lukasznowarkiewicz/I2C-SMBus-on-x86-architecture-research/README.md

# I2C / SMBus on x86 architecture research  
  
## Motivation  
  
I2C bus is super simple - most basic bus and foundation for digital communication, like DDC in HDMI, SPD in computer memory modules,  SMBUS in “Smart battery”, PMBUS for power management, image sensors configuration in CSI cameras, and so on and on.   
  
Talking to those devices on a MCU in C language is simple - often limited to communication with peripheral for sending and receiving data. But it gets more complicated on x86 architecture, which can be found in many computer systems (aka personal computers and laptops). Simple Cortex M0 core running at 100MHz is “just” one thousand faster than the slowest 100kbps I2C bus speed. But on average modern CPU running at 3GHz it is 30 thousand times faster. There is no surprise that CPU is not talking to I2C peripherals directly as probably it is waste of interrupts - as changing context on CPUs this complex is really wasteful for pipeline processing.   
  
As already found that many of small sensors like temperature, fan controllers, additional buttons aka “hot heys”, orientation sensors or even touchpads works on I2C or some variation of it like SMBUS. And was just curious how to communicate with them from the operating system. And of course all those reflections are related to future x86 project.   
  
## Approach  
  
Build simple prototype board with a few sensors working on I2C / SMBUS bus connect it to a x86 motherboard with exposed I2C signals and try to access them from the operating system.   
  
## Goals:  
  
Goals for this quick research are low - start small and achieve some basic functionality:  
  
- Communicate with some sensors on linux using i2c tools  
- Bind already build driver to a device on linux  
- Communicate with sensors on Windows 11  
  
## Understanding I2c handling on x86 architecture   
  
On an x86 SoC, I2C transfers are generated by dedicated I2C controller hardware, similar in principle to MCU I2C peripherals, but the controller is integrated into a much larger platform with firmware, pin muxing, power management, and OS enumeration around it. First, firmware configures the pads so the selected pins work as SDA/SCL instead of GPIO or another alternate function, then it enables or describes the I2C controller and any fixed devices connected to that bus. When software requests a transaction, the CPU does not bit-bang the bus; it programs controller registers or uses DMA/FIFO mechanisms, and the controller generates START, address, ACK/NACK, data bytes, repeated START, STOP, and clock timing. The important difference from a small MCU is not the existence of an I2C peripheral, but the amount of platform infrastructure around it: ACPI/firmware tables, controller drivers, device drivers, interrupts, runtime power states, and security/ownership rules. Later in the OS stack, the I2C controller becomes a bus adapter, devices on that bus become child devices, and normal applications usually access the sensor through a driver-specific or framework-specific interface rather than by directly controlling bus transactions.   

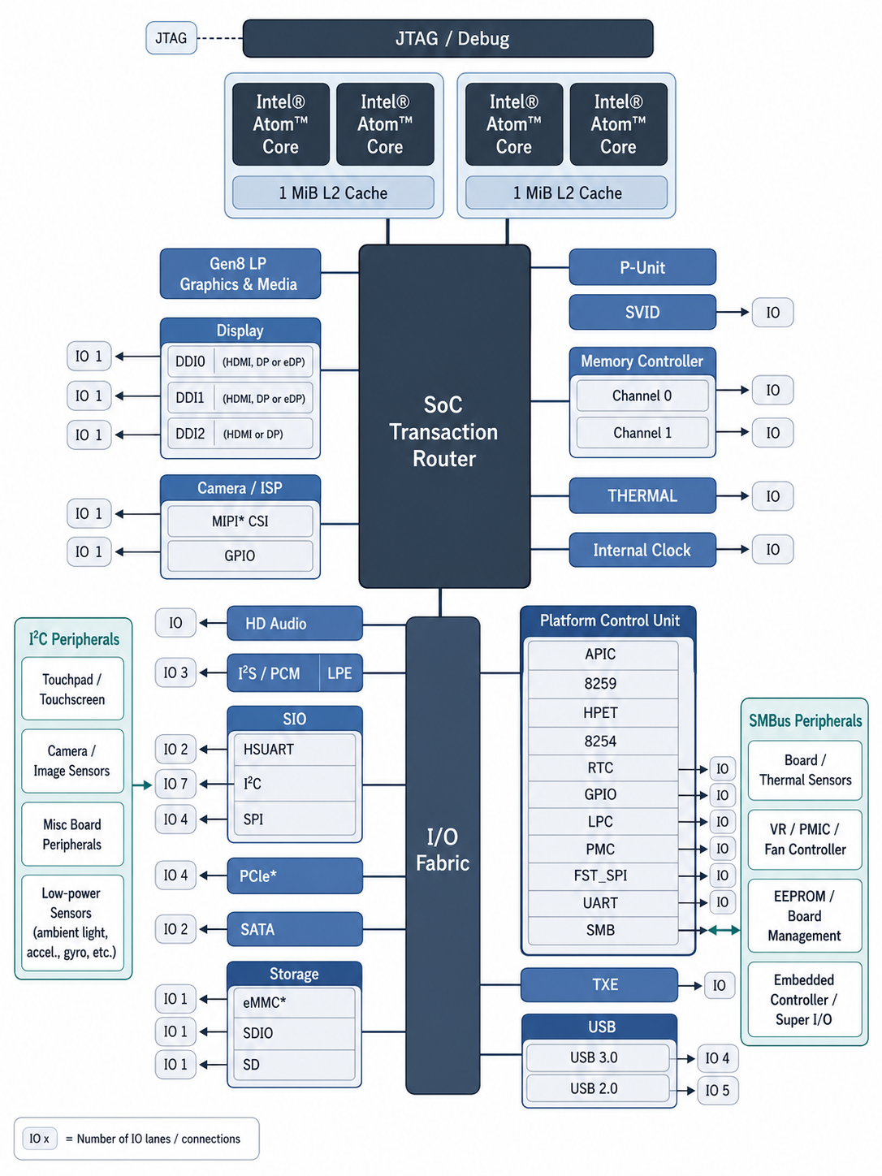
[picture p1: Attachments/B711AB3C-D2A0-412D-849C-1D97AC93C686.png]
01 •
  

## Components selection for the research  
  
For the component selection, I tried to find parts that are commonly mounted on x86-based motherboards and have proven Windows support. For the temperature sensors, I found that TMP101 and TMP175 are widely used as internal temperature sensors. For fan-speed readings, I selected the MAX6650EUB+. For the IMU/gyroscope, I chose the Bosch BNO055, the MPU-6050, and the ST LSM6DSOTR. For the GPIO expander, the choice was more arbitrary, as I could not find clear listings of specific chips used in laptops. Usually, this functionality is hidden behind a driver package for a particular laptop model, often described only as “hot keys support”.

## Hardware design - schematic  
  
In the schematic, almost all devices are connected to a single I²C bus. The board uses 5 V as the main supply, mainly because of the 5 V fan, and an LDO regulator generates the 3.3 V rail for the remaining circuitry. Pull-up resistors are provided for the SDA and SCL lines, as well as for the overtemperature signal, which could be used, for example, as a `PROC_HOT` signal.

### Schematic:  
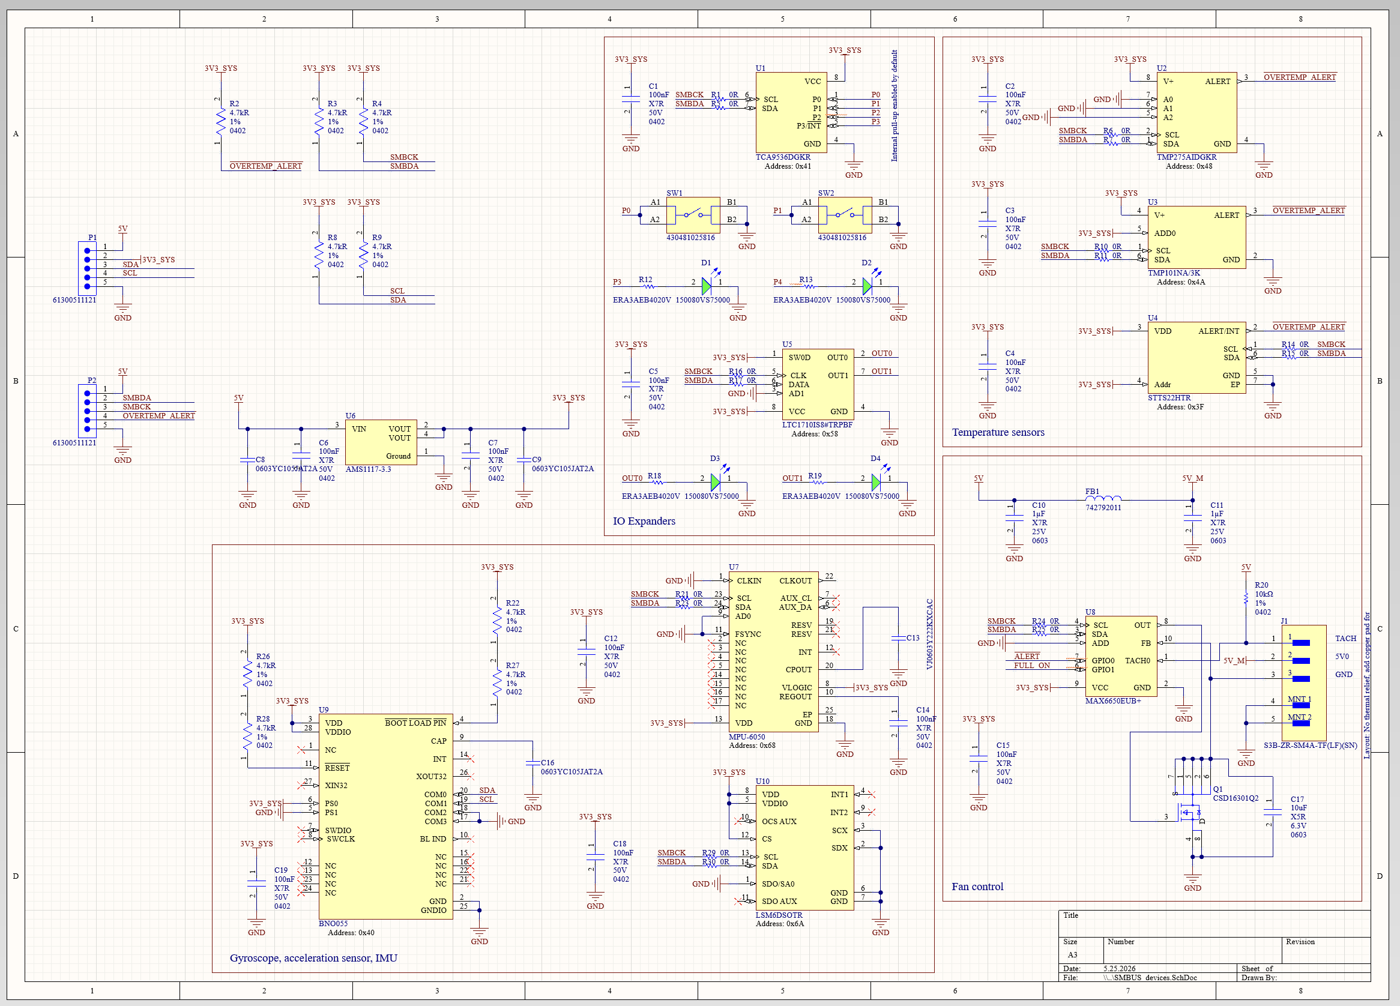
[picture p2: Attachments/11CCCEA3-3A21-467D-BA31-D675517985C5.png]
Screenshot 2026-05-25 at 19.46.35.png
  

## Hardware design - board  
  
Since I had little free time while designing the board, I decided to try PCBWay’s layout service.

I shared the entire Altium project, with the components already imported into the PCB layout:

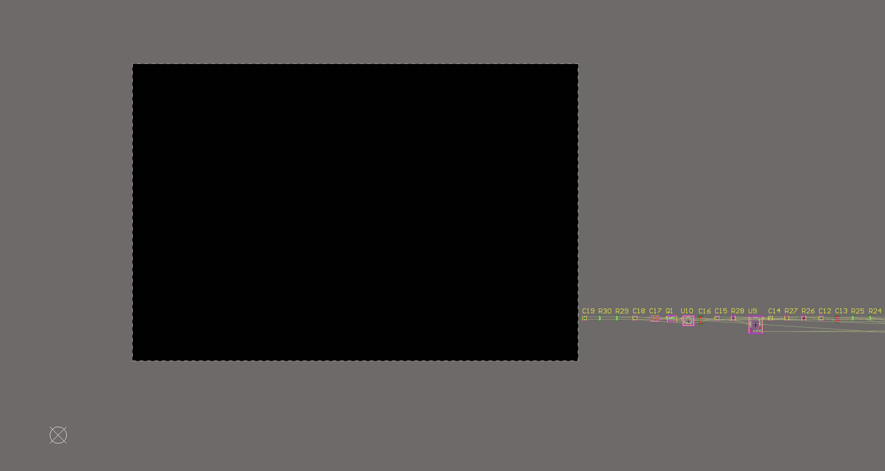
[picture p3: Attachments/1C58EC97-9770-488D-8159-F59337C1017C.png]
Screenshot 2026-06-06 at 08.18.42.png
  
  
I submitted the layout order through the PCBWay website:
  
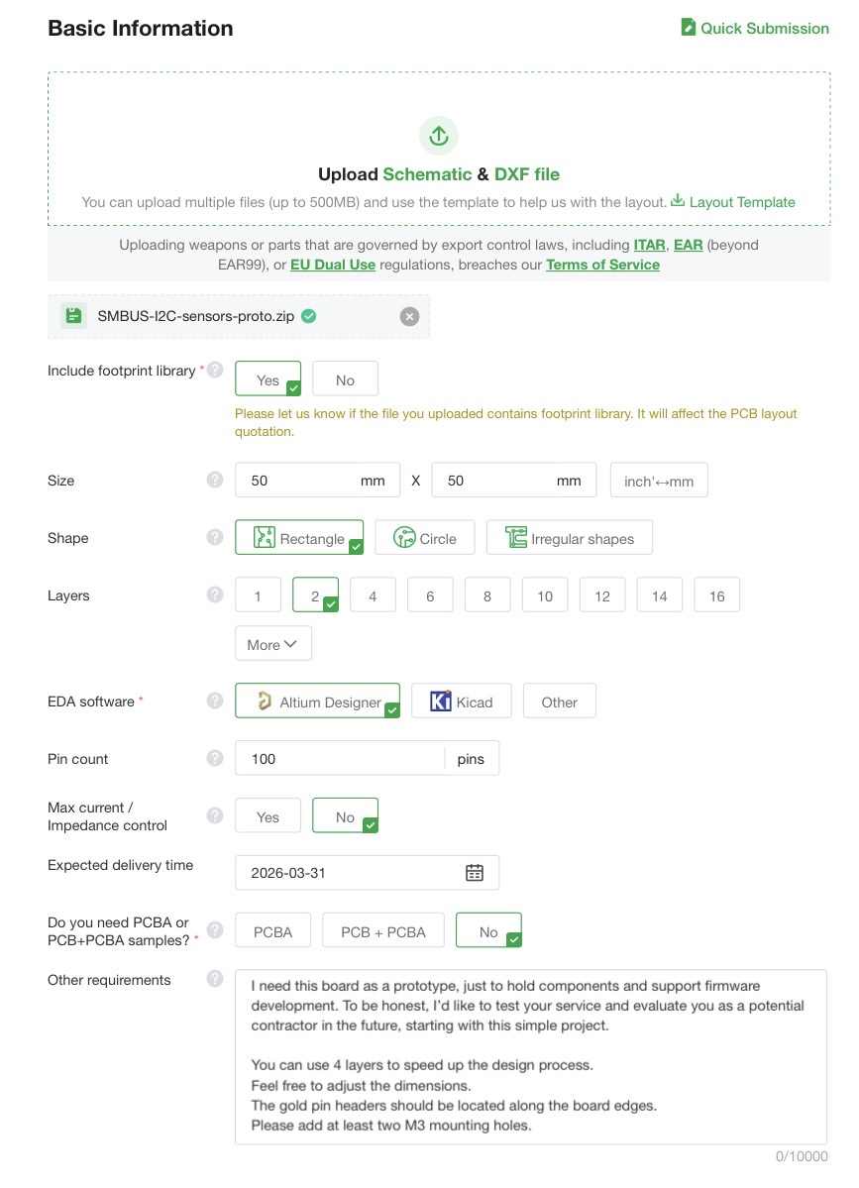
[picture p4: Attachments/9A4FDA5C-38B8-45B0-8BFF-E47C227ACC96.jpeg]
Basic Information
  
  
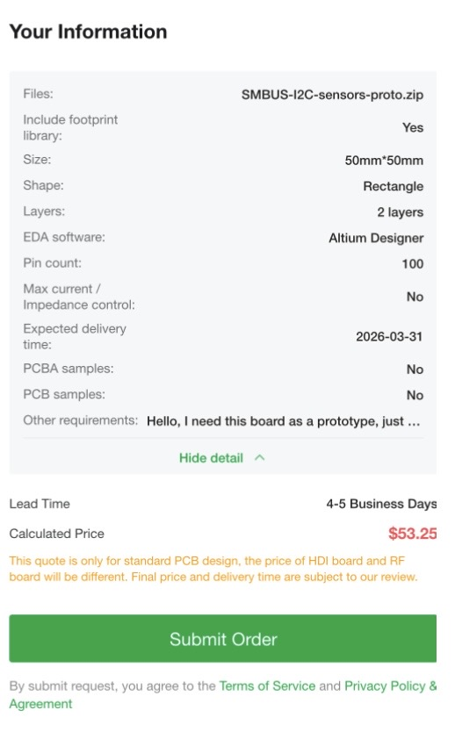
[picture p5: Attachments/A5CA129C-3088-495A-BF5F-B8A964FA2149.jpeg]
Your Information
  
  
I then received the initial component placement for review:
  
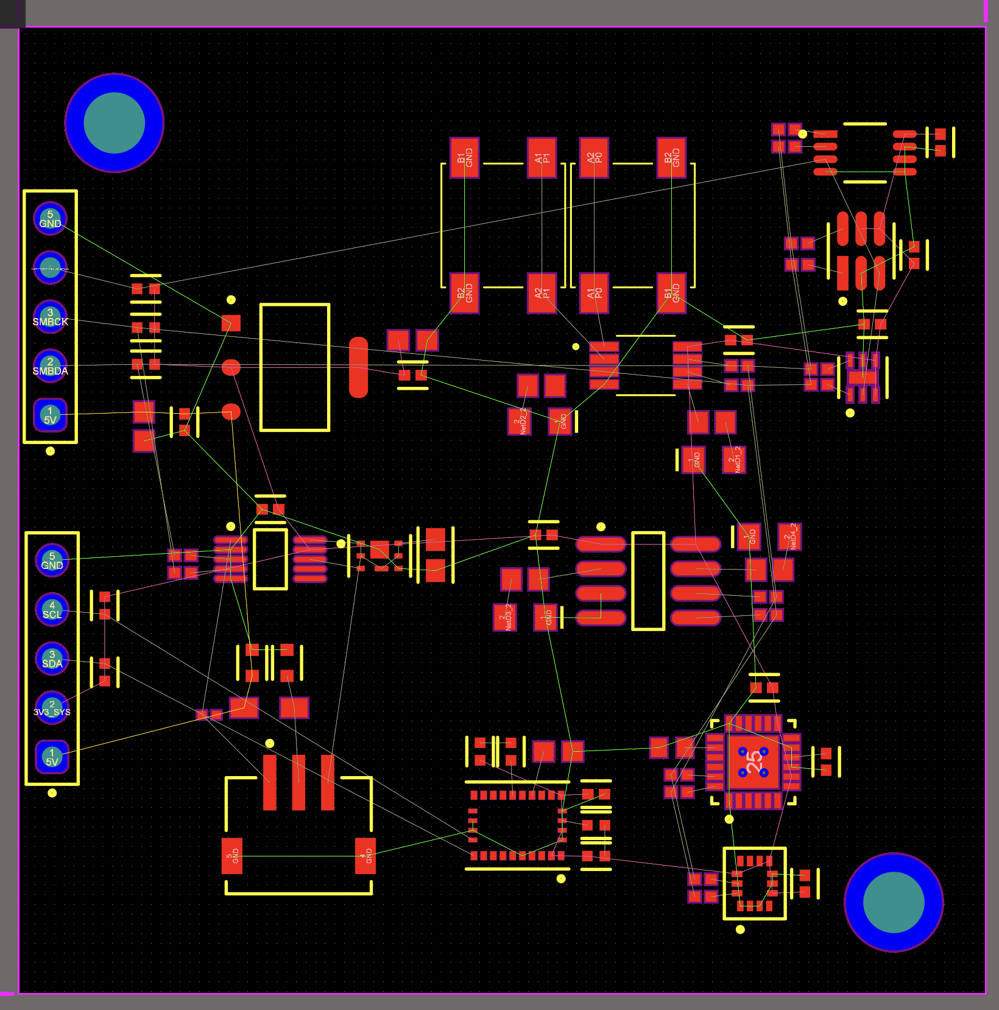
[picture p6: Attachments/7B85AB8D-54B4-4485-B792-E42F1DB74CB3.png]
KI
  
  
My feedback on the placement was to increase the distance between the switches, move the connector to the edge of the board, and add two additional mounting holes:
  
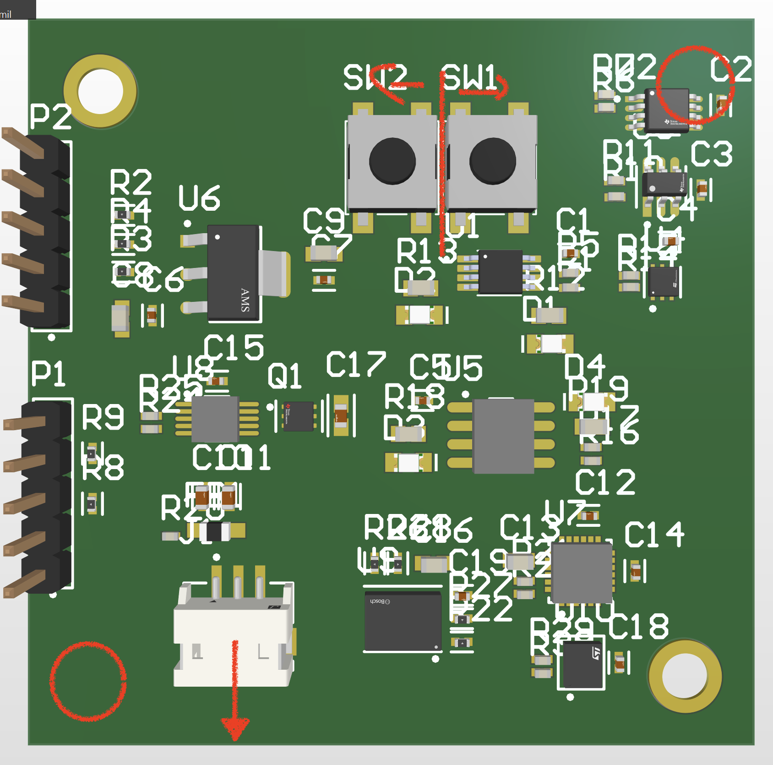
[picture p7: Attachments/5A142E30-4AD3-4D96-9F7F-76EDBB8770F3.png]
U6
  
  
I then received the final design:
  
Board:  
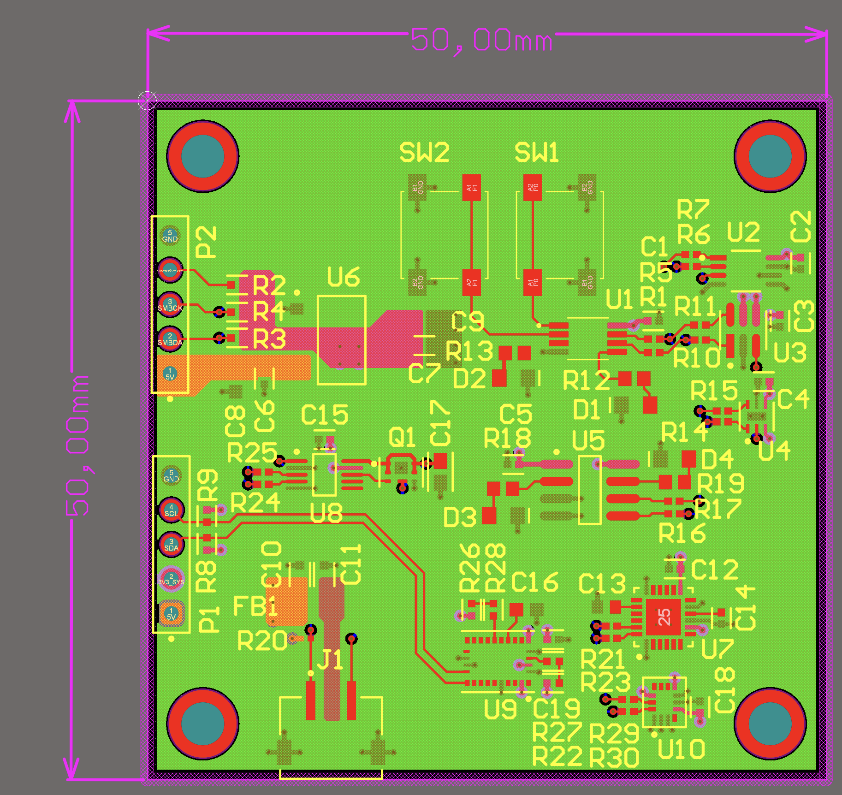
[picture p8: Attachments/AACE3CC7-D583-425D-85B8-28C8F25D9579.png]
•C8
  
  
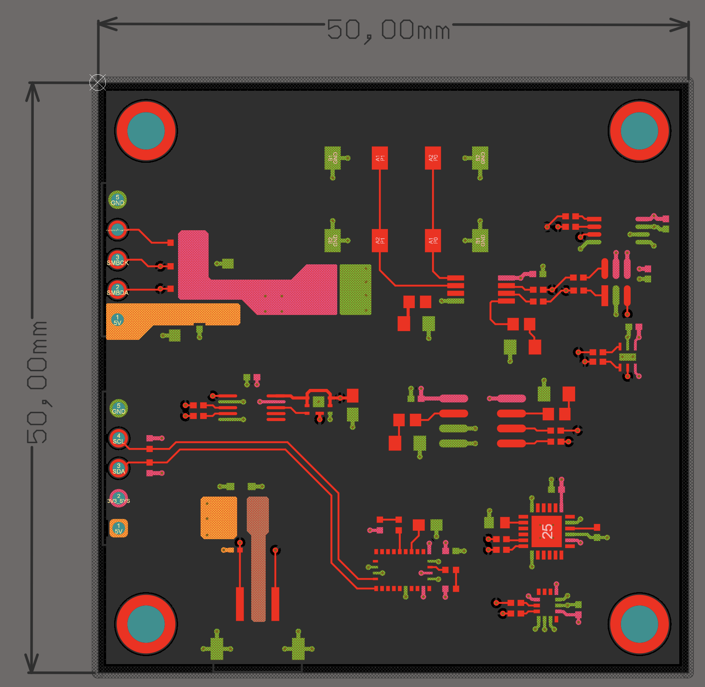
[picture p9: Attachments/97C273D0-FF5C-45F0-910F-7EBCFD2107C6.png]
50,00mm*
  
  
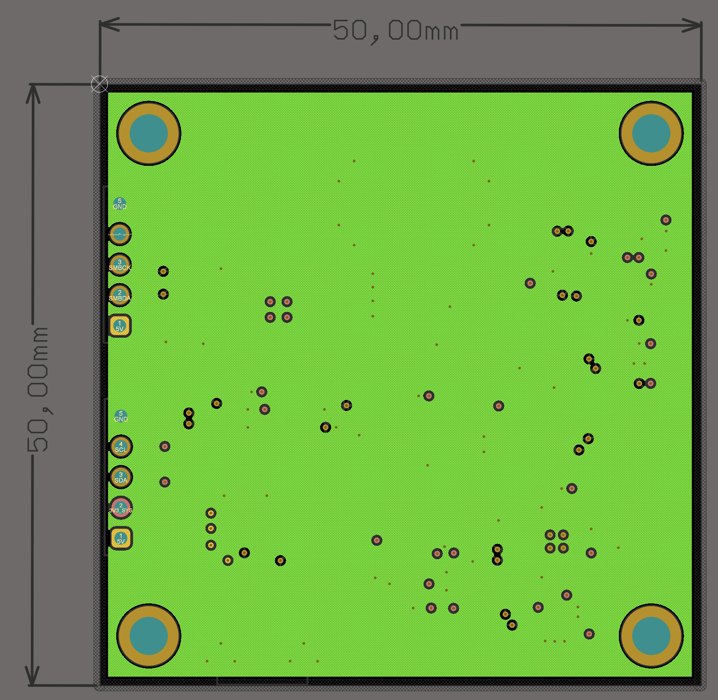
[picture p10: Attachments/A66A80FC-ED96-4A03-A9B6-D786C6430050.png]
50,00mm
  
  
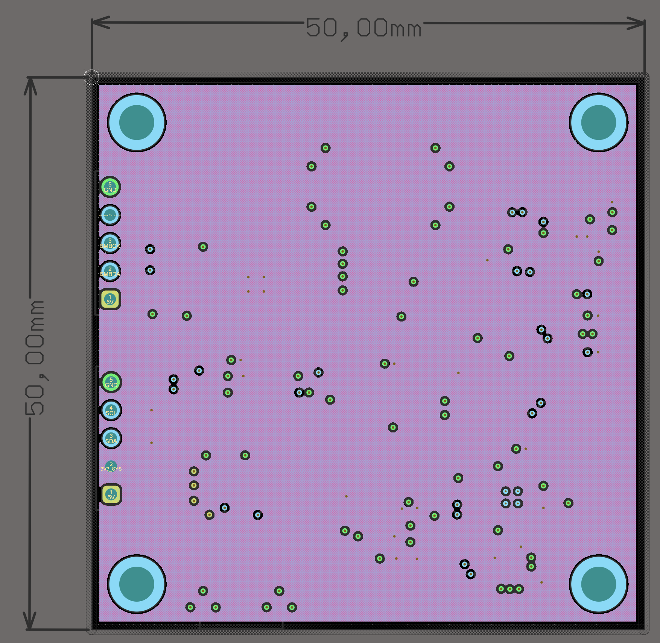
[picture p11: Attachments/0505F2DE-9F41-4C99-9035-F0E51C881270.png]
50, 00mm
  
  
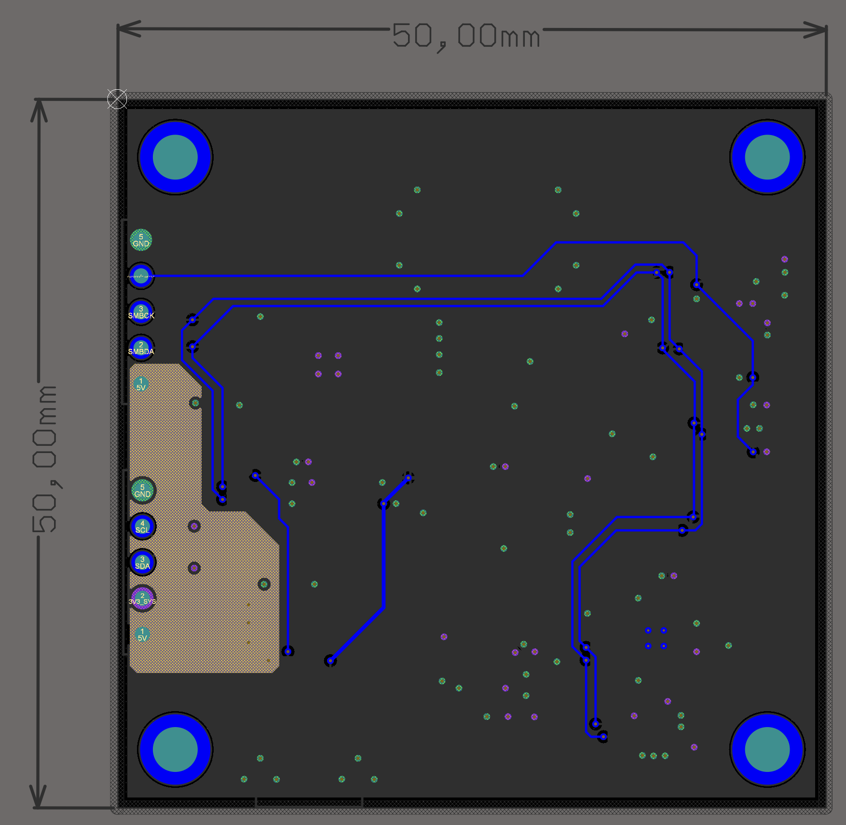
[picture p12: Attachments/32863FE4-E380-45B1-AFA6-61666BC4C738.png]
50, 00mm"
  
  
3D view:  
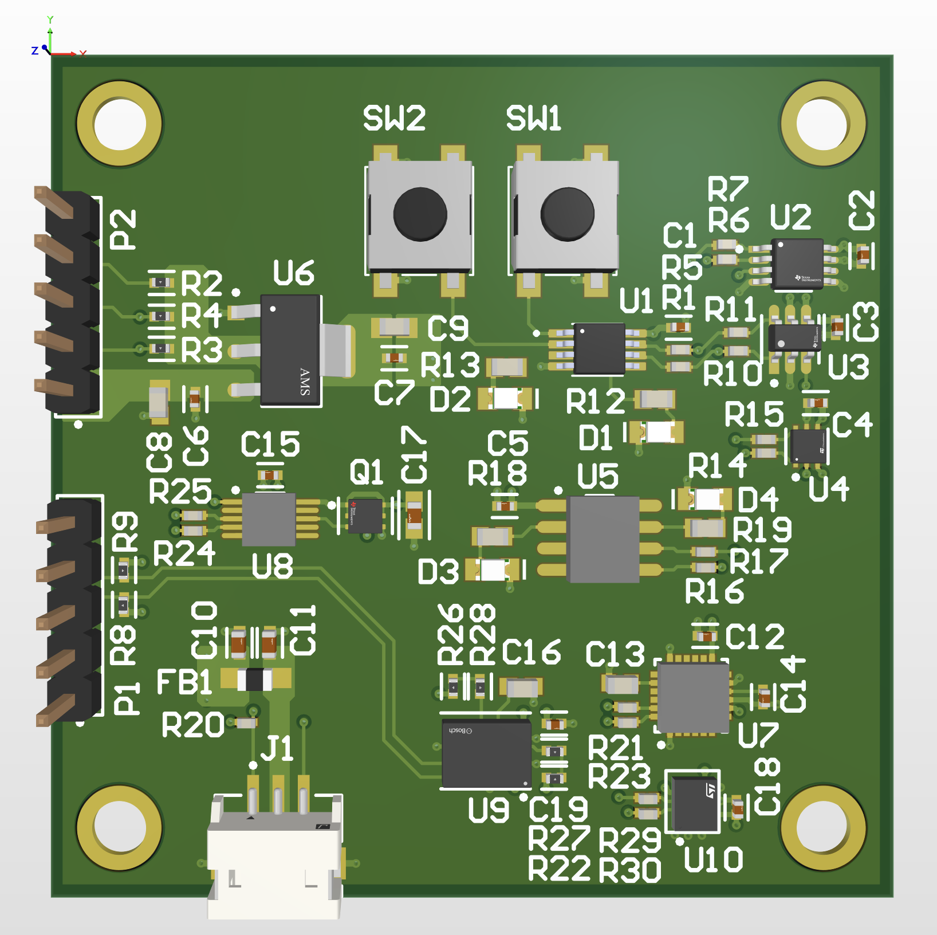
[picture p13: Attachments/F3828EFC-0B8C-4B9E-B2CE-DBCD29BB3CEA.png]
ER2.
  

**Layout review:** 
  
Overall, I am quite satisfied with the result. There was one mistake in the schematic, which was pointed out by a PCBWay engineer after the PCB layout was ordered. The routing was done properly: the I²C lines were routed together, the power traces and planes were made wider, and the internal planes were connected with multiple vias. There were also no acid traps in the tracks, so overall the layout quality was quite good. From my perspective, I would only add additional copper planes for mechanical rigidity around the buttons, fan connector, and gold-pin headers.
  
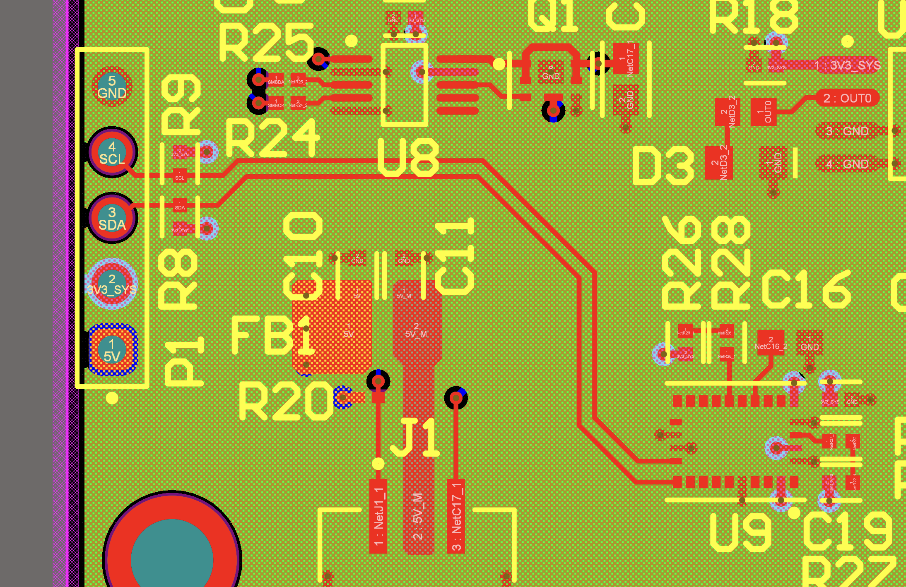
[picture p14: Attachments/629187CA-9BAF-429B-819C-90AB1296BFAC.png]
R250-
  
  
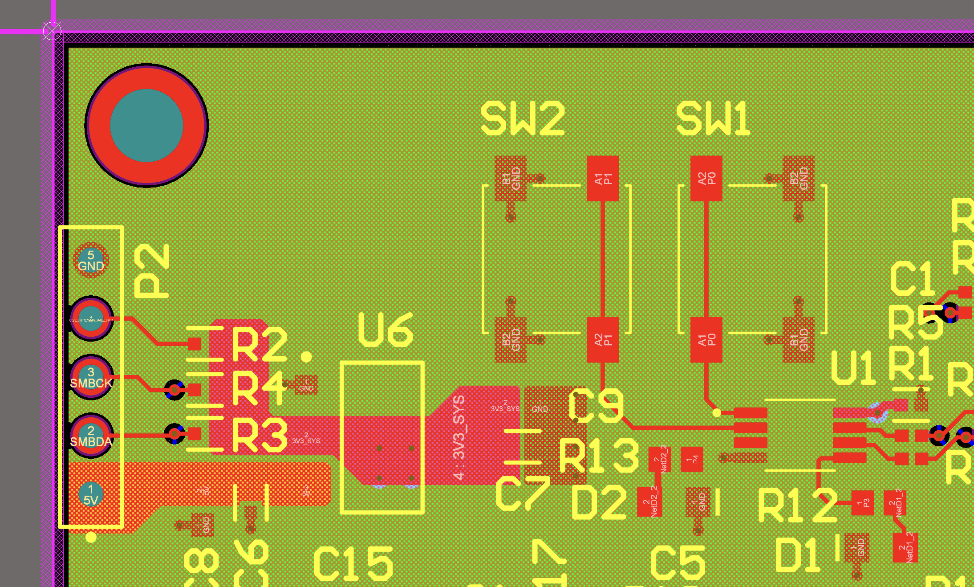
[picture p15: Attachments/8C8C0536-181C-49AF-8A91-1FA4AB64D4E4.png]
Screenshot 2026-05-25 at 19.53.40.png
  
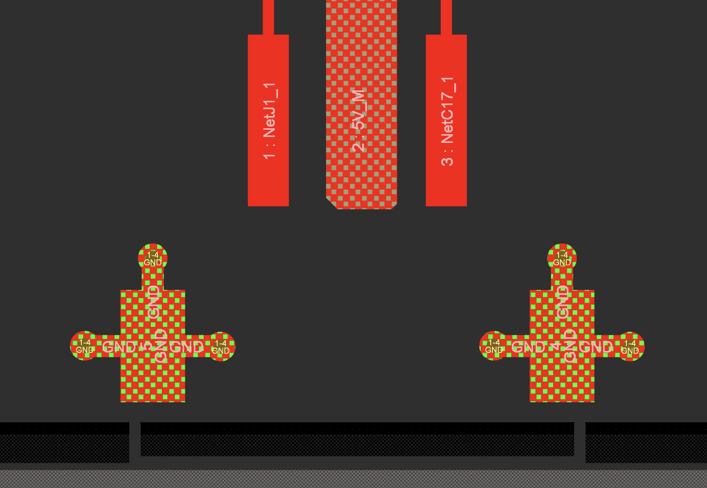
[picture p16: Attachments/A37CA132-9B90-4D5D-A9C6-D6964F79153A.png]
1: Net.1 1
##   
  
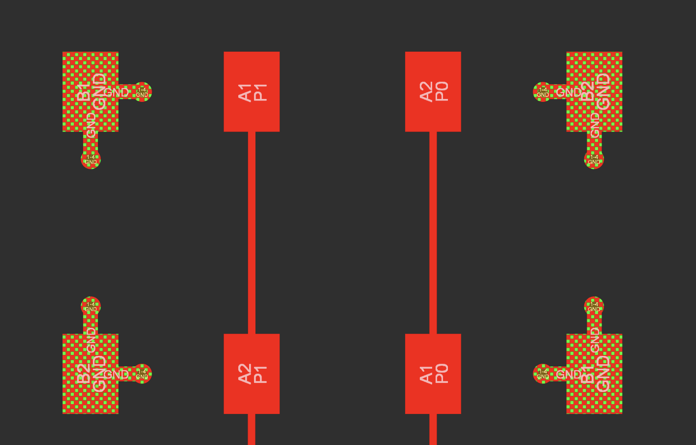
[picture p17: Attachments/AAB1B498-46C1-4410-B1E2-F75117983525.png]
Screenshot 2026-03-11 at 07.10.37.png
  
  
## Hardware manufacturing - PCB and assembly  
  
The PCBs were ordered with PCBWay’s assembly service. This part was partially sponsored by PCBWay, for which I am very grateful. It saved me a lot of time, and surprisingly, even with the assembly service, it turned out to be cheaper than buying the parts separately and hand-assembling the boards myself in Europe.

Why? Logistics.

A few ICs I selected turned out to be difficult to source in Europe. I usually use OEMSecrets for component sourcing, but several crucial components were unavailable from major distributors such as Mouser, DigiKey, and Farnell. I found them on Alibaba and AliExpress, but for such small quantities, most of the cost would have been shipping and logistics.

Surprisingly, sourcing the components was not a problem on the Chinese domestic market. After submitting the BOM, only two components required my attention. The first issue was just an MPN difference caused by different packaging. The second was a different variant of the same component: only the extended-temperature-range version was available.

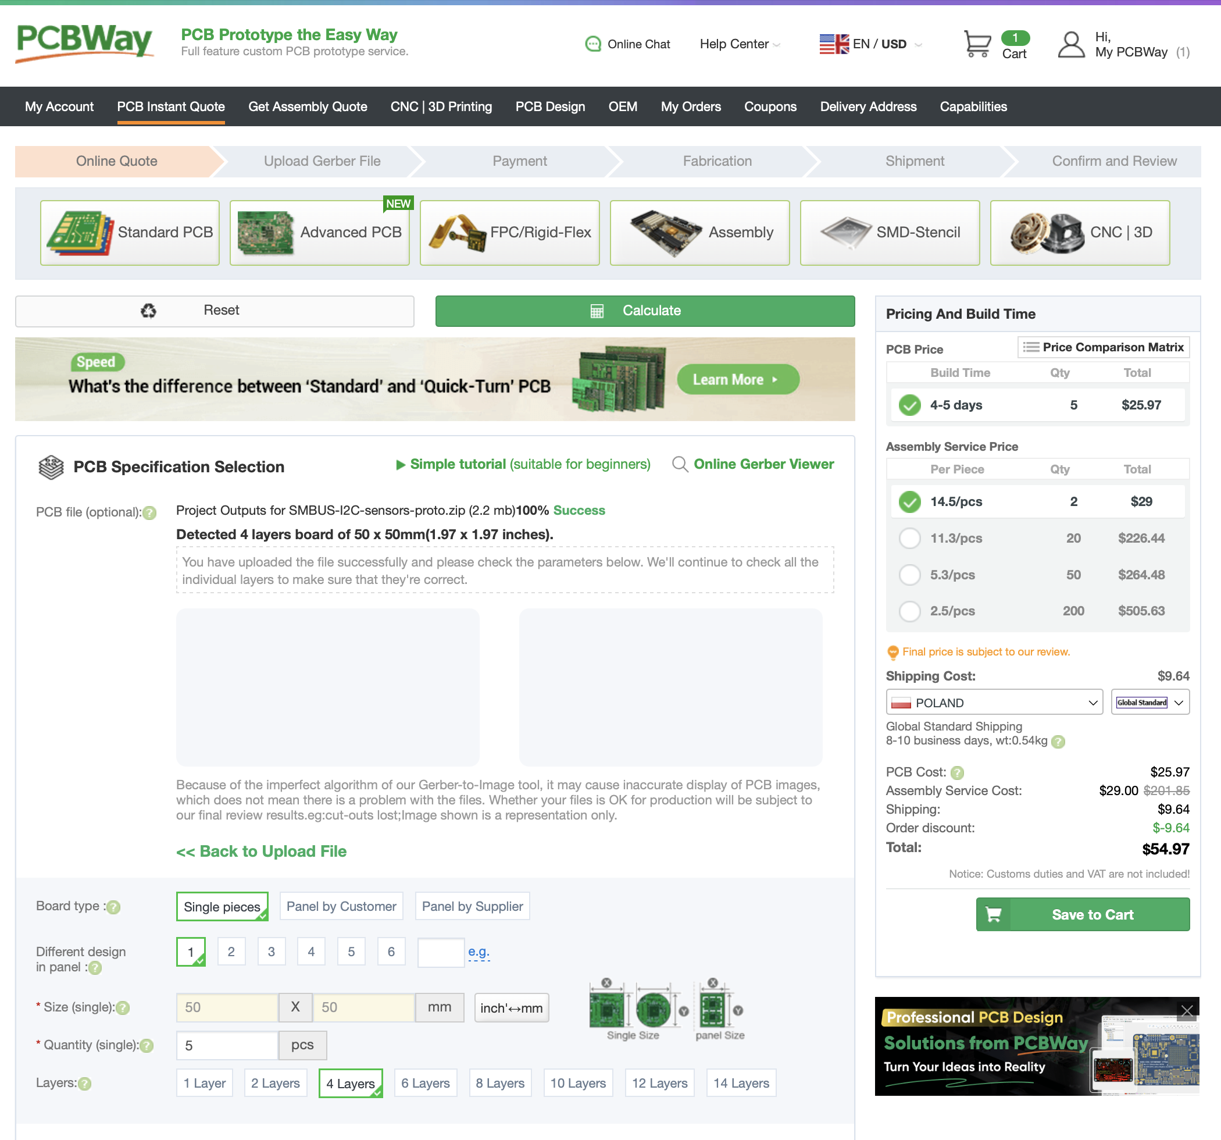
[picture p18: Attachments/C0818001-4557-412D-B9E1-4B0FE3AE6DCB.png]
PCBWay *ce Proctype the Easy Way
  
  
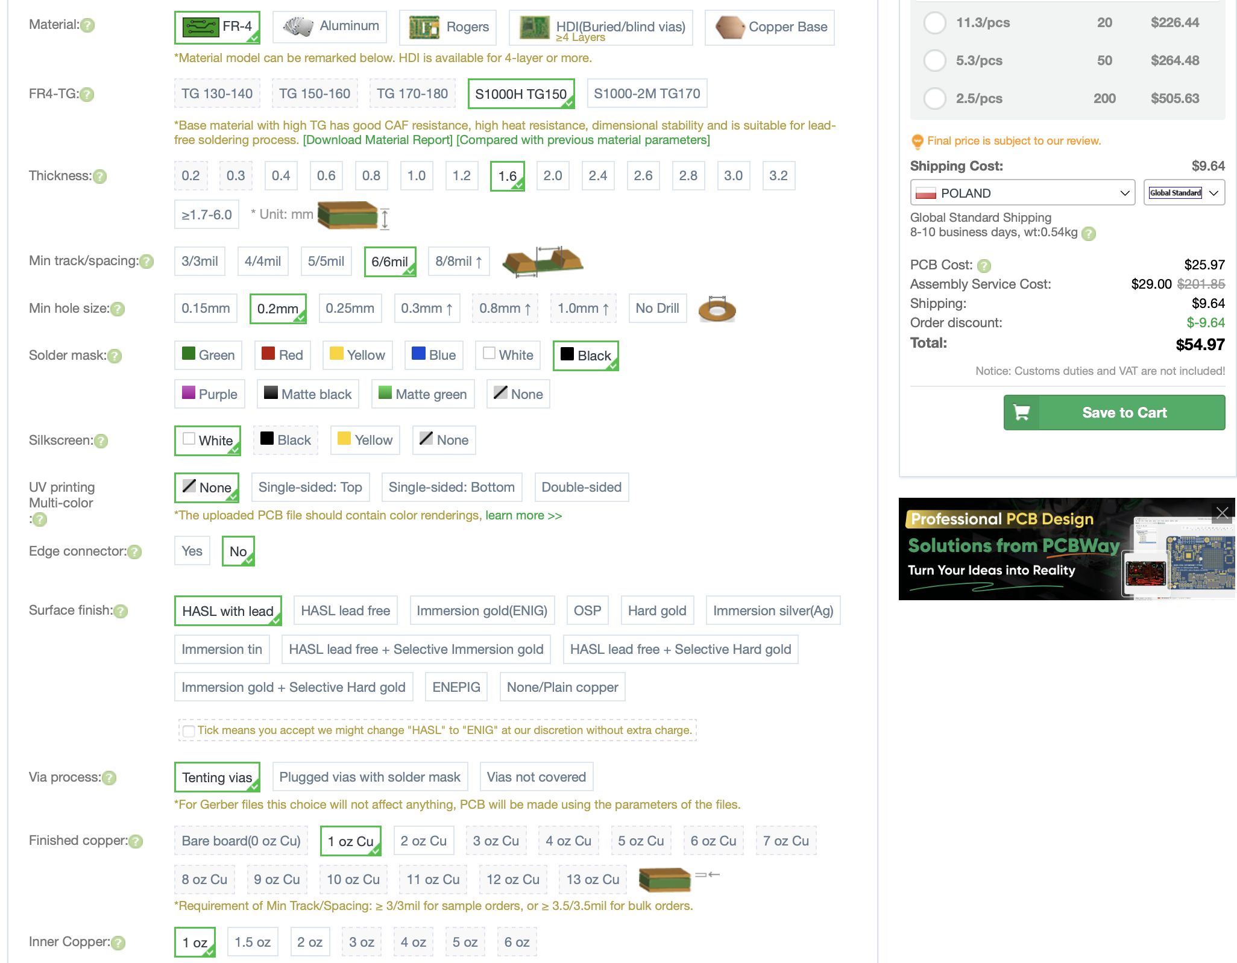
[picture p19: Attachments/0A75F936-AF28-4116-A1AB-D14D3182B3FE.png]
TO 130-540 10 150-10015:00-180|
  
  
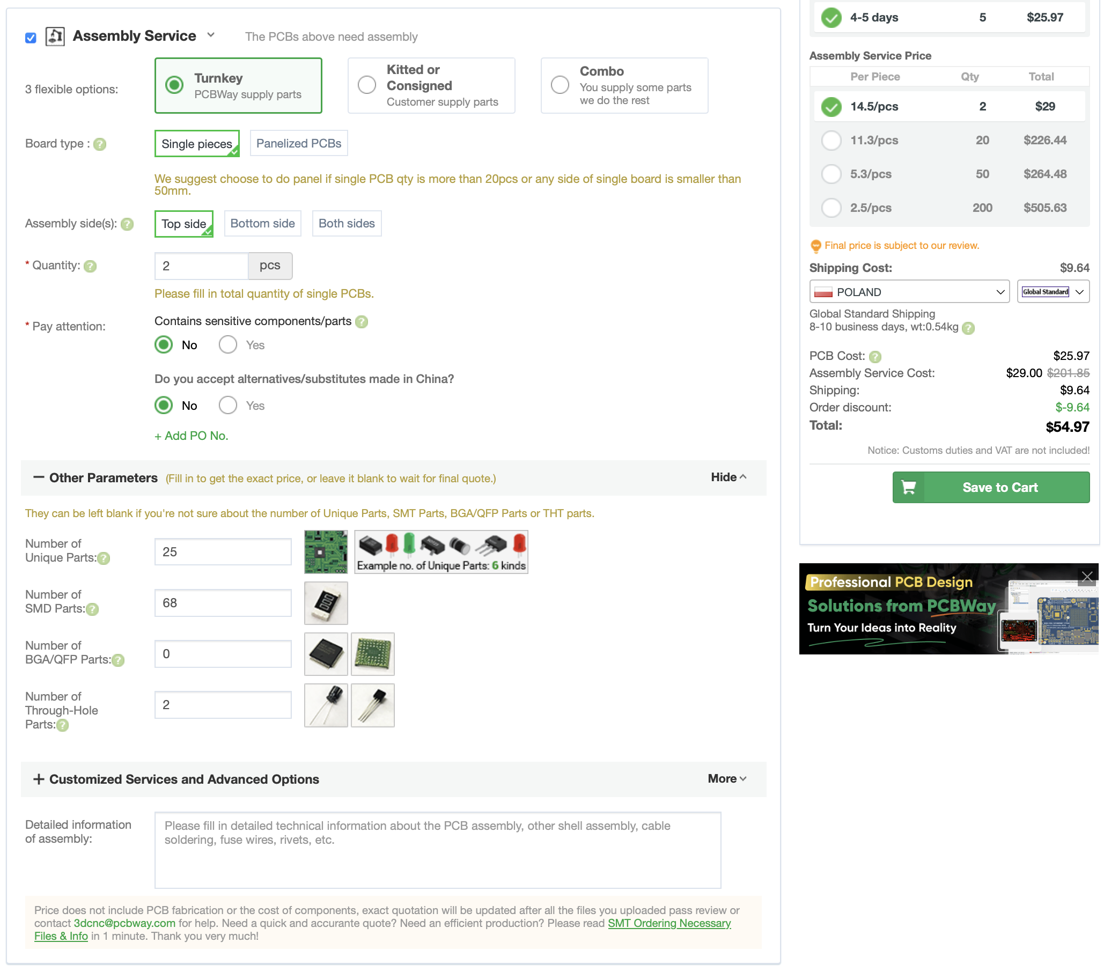
[picture p20: Attachments/6A373418-B24C-4D91-A0F8-FB6A06A81E18.png]
• hi Assembly Service i
  
  
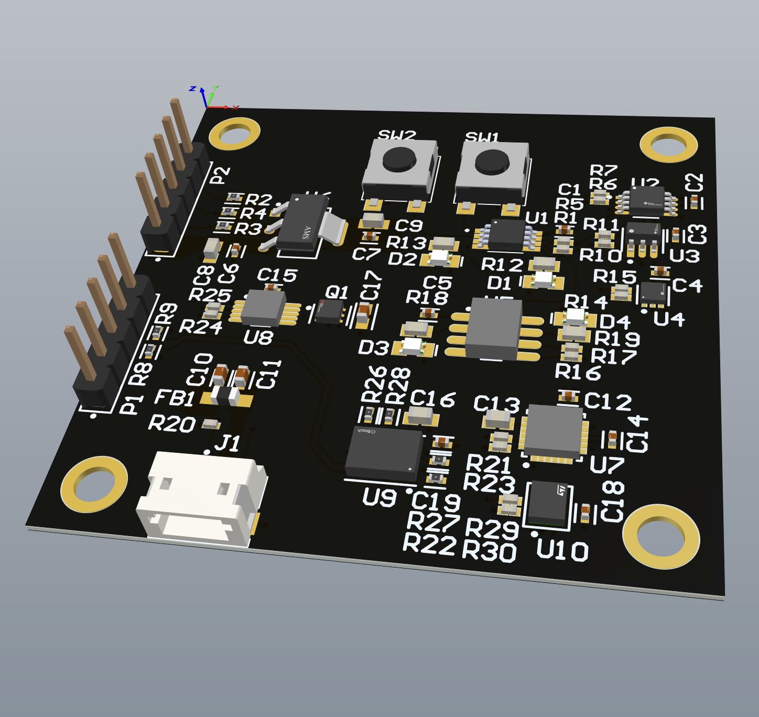
[picture p21: Attachments/D233D81A-FD06-44EF-BE42-712F0A1E425E.png]
R25
  

The received boards look great, including both the SMD-mounted components and the hand-soldered THT components.

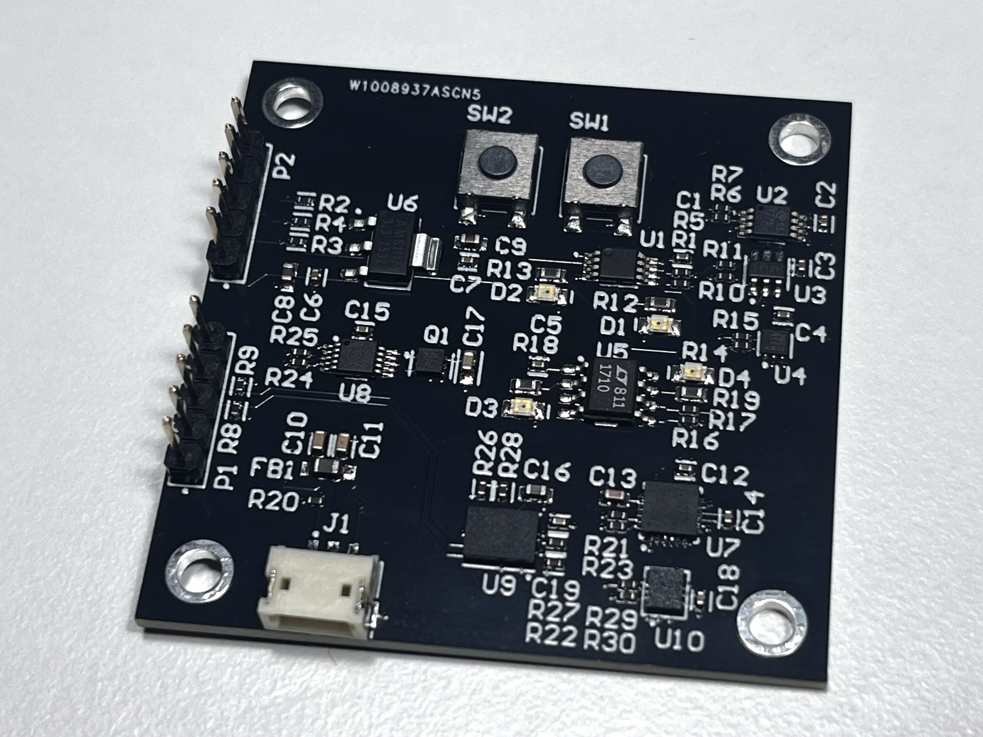
[picture p22: Attachments/01940D4C-41E8-4D1B-A3C4-8568F3423B43.jpeg]
  
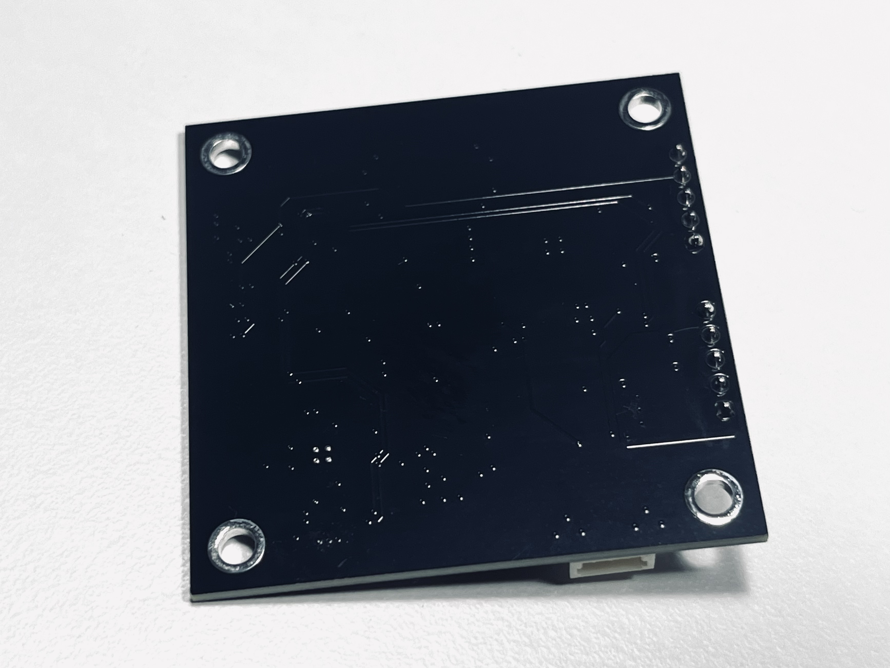
[picture p23: Attachments/EC33EA2C-758D-49B1-975E-90392AE3E7BD.jpeg]
  

## Hardware test setup  
  
It is not easy to find exposed I²C lines on most modern motherboards. One board where I could find them was the LattePanda Mu with the Lite Carrier Board, so I used it for the test setup.

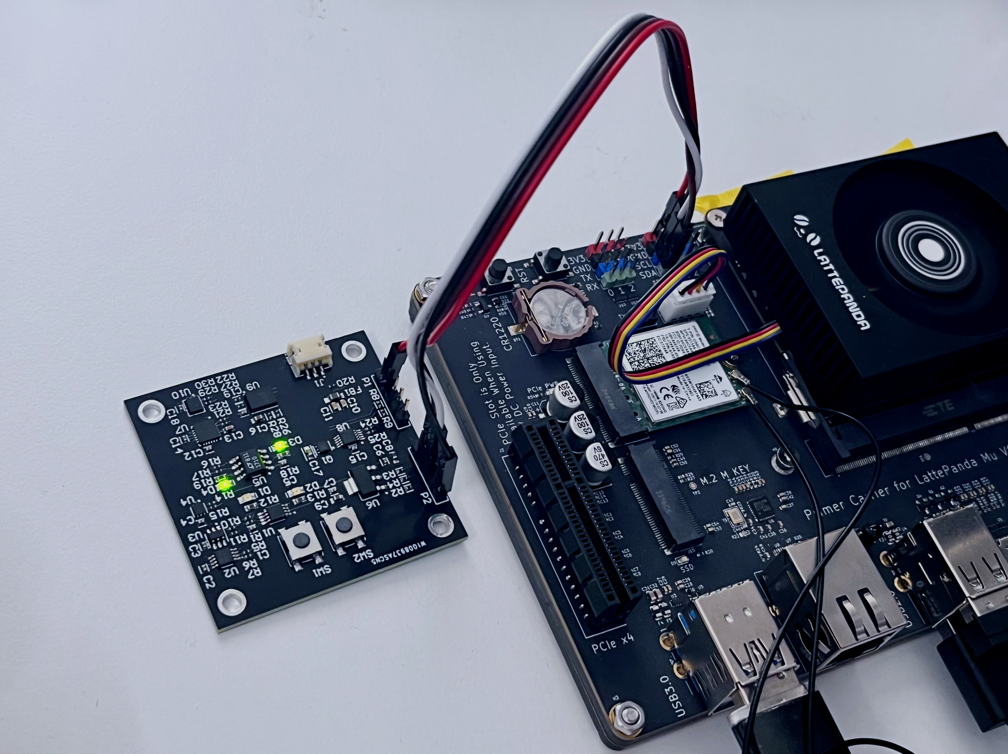
[picture p24: Attachments/2FA29C56-B4CF-44B3-9106-82A8949B6986.png]
Screenshot 2026-06-14 at 08.41.12.png
  
  
## Software test setup - Linux  

Picked most layman friendly Linux - Lubuntu 26.04  
It is equipped with apt for easy software install, comes with thousands of drivers, easy for install - seems to be good choice for a quick start.  
It runs of a usb drive as a live ISO.  
When installing or running from usb drive I believe no one ponder “from where did it know all the hardware on the motherboard?”. It just works and no one cares. But actually it is quite interesting. On most ARM platforms Linux kernel expects so called device tree binary (.dtb file) - describing all peripherals and their addresses in the memory. On x86 this information is stored in the firmware (BIOS/UEFI) in a form so called ACPI tables. This approach makes OS installation much easier as the firmware already contains information about the hardware and supplying device tree externally is not required. Linux reads it and loads required drivers. For already described modules like touch screen controller or internal temperature sensors they will “automagically” start to work. For external devices, such as a custom board with I²C sensors, Linux provides a convenient way to experiment without modifying low-level firmware, which could easily make the device harder to recover. The `i2c-tools` package uses the Linux I²C userspace interface exposed through `/dev/i2c-*`, typically provided by the `i2c-dev` kernel module. This makes direct bus testing much easier during bring-up.

## 1st goal - communication with devices on Linux using I2c-tools   
  
For the first part i2c-tools package will be used for direct communication with the devices. Intel N100 processor has 7 I2C master controllers - finding the right one was try and error method - looking for devices at expected addresses.   
  
List all available buses on the system:
```bash  
lubuntu@lubuntu:~$ i2cdetect -l  
i2c-0	unknown   	Synopsys DesignWare I2C adapter 	N/A  
i2c-1	unknown   	Synopsys DesignWare I2C adapter 	N/A  
i2c-2	unknown   	Synopsys DesignWare I2C adapter 	N/A  
i2c-3	unknown   	Synopsys DesignWare I2C adapter 	N/A  
i2c-4	unknown   	Synopsys DesignWare I2C adapter 	N/A  
i2c-5	unknown   	SMBus I801 adapter at 0000:00:1f.4	N/A  
i2c-6	unknown   	i915 gmbus dpa                  	N/A  
i2c-7	unknown   	i915 gmbus dpb                  	N/A  
i2c-8	unknown   	i915 gmbus dpc                  	N/A  
i2c-9	unknown   	i915 gmbus tc1                  	N/A  
i2c-10	unknown   	i915 gmbus tc2                  	N/A  
i2c-11	unknown   	i915 gmbus tc3                  	N/A  
i2c-12	unknown   	i915 gmbus tc4                  	N/A  
i2c-13	unknown   	i915 gmbus tc5                  	N/A  
i2c-14	unknown   	i915 gmbus tc6                  	N/A  
i2c-15	unknown   	AUX USBC2/DDI TC2/PHY TC2       	N/A  
```  

Found devices on bus 4:  
```bash
lubuntu@lubuntu:~$ sudo i2cdetect -r -y 4                    
     0  1  2  3  4  5  6  7  8  9  a  b  c  d  e  f  
00:                         -- -- -- -- -- -- -- --
10: -- -- -- -- -- -- -- -- -- -- -- -- -- -- -- --
20: -- -- -- -- -- -- -- -- -- -- -- -- -- -- -- --
30: -- -- -- -- -- -- -- -- 38 -- -- -- -- -- -- --
40: -- 41 -- -- -- -- -- -- 48 -- 4a -- -- -- -- --
50: -- -- -- -- -- -- -- -- -- -- -- -- -- -- -- --
60: -- -- -- -- -- -- -- -- 68 -- 6a -- -- -- -- --
70: -- -- -- -- -- -- -- -- 
```

Detected devices:  
  
`0x38` - STTS22HTR  
       ST digital temperature sensor.  
  
`0x41` - TCA9536DGKR  
       TI 4-bit I2C GPIO / I/O expander.  
  
`0x48` - TMP275AIDGKR  
       TI digital temperature sensor with alert output.  
  
`0x4A` - TMP101NA/3K  
       TI digital temperature sensor with alert output.  
  
`0x68` - MPU-6050  
       TDK/InvenSense 6-axis IMU:  
       3-axis accelerometer + 3-axis gyroscope.  
  
`0x6A` - LSM6DSOTR  
       ST 6-axis IMU:  
       3-axis accelerometer + 3-axis gyroscope.  
  
Not detected:  
`0x40` - BNO055 - expected as this sensor is connected to other GPIO header  
`0x58` - LTC1710IS8#TRPBF   
`0x48` - MAX6650EUB+ address conflict with TMP275AIDGKR  

### Communication with temperature sensor STTS22HTR  
  
For starters read WHOAMI register, which according to a datasheet should be 0x0A  
```bash  
lubuntu@lubuntu:~$ sudo i2cget -y 4 0x38 0x01                  
0xa0  
```  
  
Read basic registers:  
  
```bash  
# CTRL register  
lubuntu@lubuntu:~$ sudo i2cget -y 4 0x38 0x04
0x30  
  
# STATUS register  
lubuntu@lubuntu:~$ sudo i2cget -y 4 0x38 0x05              
0x00  
  
# Temperature low byte  
lubuntu@lubuntu:~$ sudo i2cget -y 4 0x38 0x06
0x00  
  
# Temperature high byte  
lubuntu@lubuntu:~$ sudo i2cget -y 4 0x38 0x07
0x00  
```  
Temperature registers return zeros - expected as sensor was not yet asked to take a measurement.   
  
```bash  
# Start one-shot conversion  
lubuntu@lubuntu:~$ sudo i2cset -y 4 0x38 0x04 0x01
  
# Read high and low temperature bytes once again  
lubuntu@lubuntu:~$ sudo i2cget -y 4 0x38 0x06              
0x32  
lubuntu@lubuntu:~$ sudo i2cget -y 4 0x38 0x07         
0x0a          
```  
  
Command for reading register values and formatting them in a human readable form:  
```bash  
lubuntu@lubuntu:~$  sudo i2cset -y 4 0x38 0x04 0x01; sleep 0.1; lo=$(sudo i2cget -y 4 0x38 0x06); hi=$(sudo i2cget -y 4 0x38 0x07); raw=$(( (hi << 8) | lo )); if [ $raw -ge 32768 ]; then raw=$((raw - 65536)); fi; awk "BEGIN { printf \"Temperature: %.2f C\n\", $raw / 100 }"  
Temperature: 26.10 C  
```  
Which in a room, close to the running CPU seems to be accurate.  

### Communication with GPIO expander TCA9536DGKR  

Based on the schematic:  
```text  
P0 = input  
P1 = input  
P2 = output  
P3 = output  
```  
  
Based on documentation - TCA9536 registers:  
```text  
0x00 - Input port  
0x01 - Output port  
0x02 - Polarity inversion  
0x03 - Configuration  
       bit = 1 means input  
       bit = 0 means output  
```  
  
Configure P0/P1 as inputs, P2/P3 as outputs:  
```bash  
# binary: 00000011  
# P0=input, P1=input, P2=output, P3=output  
sudo i2cset -y 4 0x41 0x03 0x03  
```  
  
Read P0/P1 input states (both not pressed):  
```bash  
sudo i2cget -y 4 0x41 0x00
0xff  
```  
  
Copy-paste readable version (P0 pressed):  
```bash  
v=$(sudo i2cget -y 4 0x41 0x00)  
echo "Raw input: $v"  
echo "P0 = $(( v & 1 ))"  
echo "P1 = $(( (v >> 1) & 1 ))"  
Raw input: 0xf2
P0 = 0
P1 = 1
```  
  
Set P2 high, P3 high (LEDs should lit):  
```bash  
sudo i2cset -y 4 0x41 0x01 0x0C  
```  

Set P2 low, P3 low (LEDs should turn off):  
```bash  
sudo i2cset -y 4 0x41 0x01 0x00  
```  
  
### Communication with 6-axis IMU ST LSM6DSOTR  
  
Important registers:  
```text  
0x0F - WHO_AM_I, expected 0x6C  
0x10 - CTRL1_XL, accelerometer config  
0x11 - CTRL2_G, gyroscope config  
0x20 - OUT_TEMP_L  
0x22 - OUTX_L_G  
0x28 - OUTX_L_A  
```  

Check device ID:  
```bash  
sudo i2cget -y 4 0x6a 0x0f  
```  
Expected:  
```text  
0x6c  
```  
  
Enable accelerometer and gyroscope:  
```bash  
# Accelerometer: 104 Hz, +/-2g  
sudo i2cset -y 4 0x6a 0x10 0x40  
  
# Gyroscope: 104 Hz, +/-250 dps  
sudo i2cset -y 4 0x6a 0x11 0x40  
```  
  
Copy-paste readable measurement:  
```bash  
sudo i2cset -y 4 0x6a 0x10 0x40; sudo i2cset -y 4 0x6a 0x11 0x40; sleep 0.1; \  
read16le(){ l=$(sudo i2cget -y 4 0x6a $1); h=$(sudo i2cget -y 4 0x6a $(($1+1))); v=$(( (h << 8) | l )); if [ $v -ge 32768 ]; then v=$((v-65536)); fi; echo $v; }; \  
temp=$(read16le 0x20); gx=$(read16le 0x22); gy=$(read16le 0x24); gz=$(read16le 0x26); ax=$(read16le 0x28); ay=$(read16le 0x2a); az=$(read16le 0x2c); \  
awk "BEGIN { printf \"ACC[g]: X=%.3f Y=%.3f Z=%.3f\nGYRO[dps]: X=%.3f Y=%.3f Z=%.3f\nTEMP: %.2f C\n\", $ax*0.000061, $ay*0.000061, $az*0.000061, $gx*0.00875, $gy*0.00875, $gz*0.00875, 25+$temp/256 }"  
  
ACC[g]: X=-0.013 Y=0.020 Z=1.003  
GYRO[dps]: X=0.350 Y=0.131 Z=0.481  
TEMP: 27.52 C  
```  

## 2nd goal - binding Linux driver to a IMU ST LSM6DSOTR  
  
Ubuntu comes with the driver for ST LSM6DSOTR: `st_lsm6dsx_i2c`.
  
Show driver information:  
```bash  
lubuntu@lubuntu:~$ modinfo st_lsm6dsx_i2c                                                           
filename:       /lib/modules/7.0.0-14-generic/kernel/drivers/iio/imu/st_lsm6dsx/st_lsm6dsx_i2c.ko.zst  
import_ns:      IIO_LSM6DSX  
license:        GPL v2  
description:    STMicroelectronics st_lsm6dsx i2c driver  
author:         Denis Ciocca <denis.ciocca@st.com>  
author:         Lorenzo Bianconi <lorenzo.bianconi@st.com>  
srcversion:     BDB38662716B162B17B240E  
alias:          of:N*T*Cst,asm330lhhxg1C*  
alias:          of:N*T*Cst,asm330lhhxg1  
alias:          of:N*T*Cst,asm330lhbC*  
[…]  
alias:          i2c:lsm6ds3  
depends:        st_lsm6dsx  
intree:         Y  
name:           st_lsm6dsx_i2c  
retpoline:      Y  
vermagic:       7.0.0-14-generic SMP preempt mod_unload modversions   
sig_id:         PKCS#7  
signer:         Build time autogenerated kernel key  
sig_key:        37:FB:0D:00:77:68:05:80:DD:52:99:4C:4D:8B:FB:B9:0A:23:D7:D8  
sig_hashalgo:   sha512  
signature:      78:6C:A5:61:2D:2B:DC:77:99:6E:8A:D8:AB:1B:55:DB:D6:22:3C:2C:  
                8A:D0:0A:B2:A4:FD:E3:73:2C:10:30:1B:E8:60:3E:B5:5C:D9:E4:8C:  
                F6:D8:EB:15:8E:89:93:33:88:1E:7C:63:02:00:E9:38:C4:A6:18:BD:  
                36:9F:06:51:A0:B1:EC:B0:17:D4:14:6B:16:26:EE:08:FA:C0:8E:A0:  
                06:21:15:D6:13:8D:87:CE:8C:34:17:46:25:5F:04:4C:F6:A7:B9:40:  
                A5:D0:4B:59:A0:C7:CA:23:95:5C:D3:A3:FE:7D:D8:F1:46:C2:B2:CC:  
                69:1F:AC:51:51:30:83:1F:70:2F:17:F8:C8:8D:BB:C8:34:B4:AB:AA:  
                2D:42:71:59:E6:FF:9E:BB:98:BE:0D:64:09:D0:5E:55:9A:F2:C0:2A:  
                0D:D2:0D:D6:B4:B8:17:86:FC:AC:58:0F:84:5A:E1:FC:D6:5F:2D:3D:  
                C9:DF:33:AF:A0:07:2C:05:D5:C0:D4:94:6C:56:69:17:07:4A:D1:1E:  
                24:D0:BE:90:2D:29:35:9A:25:98:16:AB:2E:B6:E7:98:51:19:03:DA:  
                25:43:86:C4:CE:6E:DC:45:67:C3:95:2E:0C:E9:8B:8C:DB:41:91:9D:  
                16:77:41:11:9E:DC:25:6D:D3:0C:BD:B1:2F:7D:A0:2D:06:45:C3:A3:  
                56:EE:70:6B:13:A1:76:2D:00:45:85:5E:74:CA:7A:81:C1:32:76:DC:  
                74:B6:5A:0B:CF:94:76:C1:3F:D3:5E:A7:DA:98:75:40:CE:03:55:69:  
                99:EC:B8:A1:66:17:2E:CF:49:6F:D9:D7:E4:C3:77:E6:FA:70:55:F3:  
                AF:30:53:4D:AC:5C:76:11:A4:18:A9:55:97:28:31:16:21:D1:4C:54:  
                D7:6F:EB:AC:2B:2E:C7:AD:4E:04:74:E0:1F:E2:46:E7:EA:26:6E:22:  
                1A:0A:B8:A5:13:B8:43:62:09:52:42:37:4C:D3:69:11:02:37:40:A2:  
                22:86:E9:DF:1A:B8:0B:08:F7:48:E2:C0:CB:59:25:96:A2:F5:34:AC:  
                0C:4C:DC:3B:D7:04:81:AC:71:83:93:04:BD:37:48:D1:72:98:99:8E:  
                91:C1:02:04:2E:9F:2A:40:FC:A9:BF:96:FB:F3:85:E9:79:CD:72:64:  
                58:2D:92:74:99:C3:6D:61:95:BD:D8:6C:52:55:92:65:EE:6B:F1:D4:  
                45:BC:48:15:6F:63:E6:F7:D3:65:73:3A:04:3E:C8:B0:25:C2:B4:EE:  
                F6:01:37:98:EF:53:7C:AA:A2:78:32:78:E0:00:66:95:78:26:47:CC:  
                95:53:23:46:D6:24:18:43:67:A1:86:E7  
  
```  
  
Load the driver:  
```bash  
lubuntu@lubuntu:~$ sudo modprobe st_lsm6dsx_i2c  
```  
  
Manually instantiate the I²C device via sysfs so the kernel knows that an lsm6dso sensor exists at address 0x6a on I²C bus 4. Normally this information comes from ACPI or Device Tree, but new_device provides a simple runtime way to register the device with the OS.

```bash
lubuntu@lubuntu:~$ echo lsm6dso 0x6a | sudo tee /sys/bus/i2c/devices/i2c-4/new_device               
lsm6dso 0x6a  
```

After manually instantiating the device, i2cdetect run to verify the state of I²C bus 4. The UU entry at address 0x6a indicates that the address is occupied and currently claimed by a kernel driver, which confirms that the manually added lsm6dso device was registered and bound by the kernel.

```bash
lubuntu@lubuntu:~$ sudo i2cdetect -y -r 4                                                           
     0  1  2  3  4  5  6  7  8  9  a  b  c  d  e  f  
00:                         -- -- -- -- -- -- -- --   
10: -- -- -- -- -- -- -- -- -- -- -- -- -- -- -- --   
20: -- -- -- -- -- -- -- -- -- -- -- -- -- -- -- --   
30: -- -- -- -- -- -- -- -- 38 -- -- -- -- -- -- --   
40: -- 41 -- -- -- -- -- -- 48 -- 4a -- -- -- -- --   
50: -- -- -- -- -- -- -- -- -- -- -- -- -- -- -- --   
60: -- -- -- -- -- -- -- -- 68 -- UU -- -- -- -- --   
70: -- -- -- -- -- -- -- --   
```

Once the driver is bound, the sensor is exposed through the Linux IIO subsystem. The LSM6DSO driver creates separate IIO devices for the gyroscope and accelerometer.

```bash
lubuntu@lubuntu:~$ grep -R . /sys/bus/iio/devices/iio:device*/name
/sys/bus/iio/devices/iio:device0/name:lsm6dso_gyro
/sys/bus/iio/devices/iio:device1/name:lsm6dso_accel
```

The exact `iio:deviceX` numbering may vary between boots, so the device paths can be resolved by name:

```bash
lubuntu@lubuntu:~$ GYRO_DEV=$(dirname "$(grep -l '^lsm6dso_gyro$' /sys/bus/iio/devices/iio:device*/name)")
lubuntu@lubuntu:~$ ACCEL_DEV=$(dirname "$(grep -l '^lsm6dso_accel$' /sys/bus/iio/devices/iio:device*/name)")
```

Verify the resolved paths:

```bash
lubuntu@lubuntu:~$ echo "$GYRO_DEV"
/sys/bus/iio/devices/iio:device0

lubuntu@lubuntu:~$ echo "$ACCEL_DEV"
/sys/bus/iio/devices/iio:device1
```

Read raw gyroscope values from the gyroscope IIO device:

```bash
lubuntu@lubuntu:~$ cat "$GYRO_DEV/in_anglvel_x_raw"
43
lubuntu@lubuntu:~$ cat "$GYRO_DEV/in_anglvel_y_raw"
13
lubuntu@lubuntu:~$ cat "$GYRO_DEV/in_anglvel_z_raw"
59
lubuntu@lubuntu:~$ cat "$GYRO_DEV/in_anglvel_scale"
0.000152716
```

Read raw accelerometer values from the accelerometer IIO device:

```bash
lubuntu@lubuntu:~$ cat "$ACCEL_DEV/in_accel_x_raw"
284
lubuntu@lubuntu:~$ cat "$ACCEL_DEV/in_accel_y_raw"
-230
lubuntu@lubuntu:~$ cat "$ACCEL_DEV/in_accel_z_raw"
16433
lubuntu@lubuntu:~$ cat "$ACCEL_DEV/in_accel_scale"
0.000598205
```

## 3rd goal - communication with a device on ~~Windows 11~~ Lubuntu 26.04 using ACPI

The initial goal was to add one custom I²C device on Windows 11. Since the sensor is connected to an internal I²C bus on an x86 machine, the proper way to describe the hardware to the operating system is through ACPI.

In theory, this should be similar to embedded Linux Device Tree overlays: describe the device, expose it to the OS, bind a driver, and use it from userspace.

In practice, doing this on Windows requires entering the Microsoft driver development universe: ACPI tables, INF files, driver signing, WDK tooling, and a much less friendly development/debug loop. After spending some time researching that path, I decided to switch to Lubuntu 26.04 for development.

The new plan was:

1. Use Lubuntu 26.04 as the development OS.
2. Add the IMU to the system using an ACPI SSDT overlay.
3. Bind the existing Linux kernel driver to the ACPI-enumerated I²C device.
4. Confirm that the IMU appears as normal Linux IIO devices.
5. Use accelerometer data to rotate the screen.

This still closely reflects the Windows approach, because the important part is the same: the device is no longer manually instantiated through sysfs. Instead, it is described in ACPI, just like a firmware-provided device would be.

### Why ACPI?

On embedded Linux boards, custom hardware is often described with Device Tree. On x86 computers, the equivalent hardware-description mechanism is ACPI.

Without ACPI, the IMU can still be tested manually, as shown in previous chapters, using `i2cget`, `i2cset`, or by creating a temporary I²C device through:

```bash
echo lsm6dso 0x6a | sudo tee /sys/bus/i2c/devices/i2c-4/new_device
```

This is useful for testing, but it is not how a real system should expose hardware.

A proper system-level integration should tell the OS:

* which I²C controller the device is connected to,
* what I²C address it uses,
* what compatible device type it is,
* and which kernel driver should bind to it.

On this machine, the IMU is connected to Linux I²C bus 4 at address `0x6a`. However, ACPI does not use Linux bus names such as `i2c-4`. ACPI uses firmware namespace paths.

The first step was therefore to find the ACPI path behind Linux `i2c-4`.

### Finding the ACPI path of I²C bus 4

The Linux I²C bus was already known:

```bash
i2c-4
```

The ACPI firmware node for this bus can be found through sysfs:

```bash
readlink -f /sys/bus/i2c/devices/i2c-4/firmware_node
```

On this system it returned:

```text
/sys/devices/LNXSYSTM:00/LNXSYBUS:00/PNP0A08:00/device:69
```

This is not yet the ACPI namespace path. It is the Linux sysfs path to the ACPI firmware node.

The real ACPI path can be read from the `path` file:

```bash
cat /sys/bus/i2c/devices/i2c-4/firmware_node/path
```

Result:

```text
\_SB_.PC00.I2C5
```

So even though Linux calls the bus `i2c-4`, the ACPI controller path is:

```text
\_SB_.PC00.I2C5
```

This mismatch is normal. The ACPI SSDT must use the ACPI path, not the Linux bus number.

### Creating an ACPI SSDT overlay

The goal is to describe the ST LSM6DSO IMU as a child device of the I²C controller `\_SB_.PC00.I2C5`.

Important values:

```text
I²C controller ACPI path: \_SB_.PC00.I2C5
I²C address:              0x6a
Sensor:                   ST LSM6DSO / LSM6DSOTR
Linux driver:             st_lsm6dsx_i2c
Compatible string:        st,lsm6dso
```

Create a working directory:

```bash
mkdir -p ~/acpi-lsm6dso
cd ~/acpi-lsm6dso
nano ssdt-lsm6dso.asl
```

Create the following ASL file. ASL stands for ACPI Source Language and it is written in human readable form. In this file we create a small SSDT overlay that adds the LSM6DSO as a child device of the existing I²C controller `\_SB_.PC00.I2C5`, describes its I²C address `0x6a`, and provides the `st,lsm6dso` compatible string so Linux can bind the `st_lsm6dsx_i2c` driver.

```asl
DefinitionBlock ("", "SSDT", 2, "USER", "LSM6DSO", 0x00000001)
{
    External (\_SB_.PC00.I2C5, DeviceObj)

    Scope (\_SB_.PC00.I2C5)
    {
        Device (IMU0)
        {
            Name (_HID, "PRP0001")
            Name (_DDN, "STMicroelectronics LSM6DSO 6-axis IMU")

            Name (_CRS, ResourceTemplate ()
            {
                I2cSerialBusV2 (
                    0x6A,
                    ControllerInitiated,
                    400000,
                    AddressingMode7Bit,
                    "\\_SB_.PC00.I2C5",
                    0x00,
                    ResourceConsumer,
                    ,
                    Exclusive
                )
            })

            Name (_DSD, Package ()
            {
                ToUUID ("daffd814-6eba-4d8c-8a91-bc9bbf4aa301"),
                Package ()
                {
                    Package () { "compatible", "st,lsm6dso" }
                }
            })
        }
    }
}
```

Let's break it into pieces:

```asl
DefinitionBlock ("", "SSDT", 2, "USER", "LSM6DSO", 0x00000001)
```

This defines a new ACPI table. `SSDT` means **Secondary System Description Table**, which is an additional ACPI table loaded alongside the firmware-provided tables. `USER` is the OEM ID, `LSM6DSO` is the table ID, and `0x00000001` is the table revision.

```asl
External (\_SB_.PC00.I2C5, DeviceObj)
```

This tells the ASL compiler that `\_SB_.PC00.I2C5` already exists in another ACPI table. In this case, it is the existing firmware-defined I²C controller that Linux exposes as `i2c-4`.

```asl
Scope (\_SB_.PC00.I2C5)
```

This opens the namespace of that existing I²C controller. Everything inside this block is added below `\_SB_.PC00.I2C5`.

```asl
Device (IMU0)
```

This creates a new ACPI device named `IMU0` under the I²C controller. The name is local to ACPI and can be any valid four-character ACPI name.

```asl
Name (_HID, "PRP0001")
```

`_HID` is the ACPI Hardware ID. `PRP0001` is used when Linux should match the device using the Device Tree-style `compatible` property from `_DSD`.

```asl
Name (_DDN, "STMicroelectronics LSM6DSO 6-axis IMU")
```

`_DDN` is a human-readable device description. It is useful for debugging and documentation, but it is not the main driver-matching mechanism.

```asl
Name (_CRS, ResourceTemplate ()
```

`_CRS` means **Current Resource Settings**. This section describes the hardware resources used by the device. For this IMU, the important resource is the I²C connection.

```asl
I2cSerialBusV2 (
    0x6A,
    ControllerInitiated,
    400000,
    AddressingMode7Bit,
    "\\_SB_.PC00.I2C5",
    0x00,
    ResourceConsumer,
    ,
    Exclusive
)
```

This describes the I²C bus connection. `0x6A` is the 7-bit I²C address of the LSM6DSO. `400000` is the bus speed, 400 kHz. `AddressingMode7Bit` means the device uses a normal 7-bit I²C address. `"\\_SB_.PC00.I2C5"` points back to the parent I²C controller. `ResourceConsumer` means the IMU consumes this bus resource. `Exclusive` means this I²C address/resource is intended for this device only.

```asl
Name (_DSD, Package ()
```

`_DSD` means **Device Specific Data**. Linux uses this section to read extra device properties that are not represented by standard ACPI fields.

```asl
ToUUID ("daffd814-6eba-4d8c-8a91-bc9bbf4aa301")
```

This UUID identifies the standard ACPI device-properties format. It tells Linux that the following package contains key/value properties such as `compatible`.

```asl
Package () { "compatible", "st,lsm6dso" }
```

This is the key driver-matching property. It tells Linux that this ACPI device is compatible with `st,lsm6dso`. The `st_lsm6dsx_i2c` driver has a matching alias for this compatible string, so the kernel can bind the IMU to that driver.

### Compiling the SSDT

Install the ACPI compiler tools:

```bash
sudo apt update
sudo apt install -y acpica-tools
```

The `.asl` file is only the human-readable source.  Compile the ASL file into AML.

```bash
cd ~/acpi-lsm6dso
iasl -tc ssdt-lsm6dso.asl
```

Expected output:

```text
ssdt-lsm6dso.aml
```

This AML file is the binary ACPI table that will be loaded into the running kernel.

### Loading the SSDT at runtime

For development, the SSDT is loaded at runtime instead of being flashed into the BIOS. Linux exposes this runtime ACPI table-loading mechanism through `configfs`, a virtual filesystem under `/sys/kernel/config`.

The following commands load the needed kernel support and make sure `configfs` is mounted:

```bash
sudo modprobe configfs
sudo modprobe acpi_configfs 2>/dev/null || sudo modprobe acpi-configfs 2>/dev/null || true
sudo mount -t configfs none /sys/kernel/config 2>/dev/null || true
```

Check that the ACPI table interface exists:

```bash
ls -la /sys/kernel/config/acpi/table
```

Example output:
```bash
lubuntu@lubuntu:~$ ls -la /sys/kernel/config/acpi/table
total 0
drwxr-xr-x 4 root root 0 Jun 10 06:53 .
drwxr-xr-x 3 root root 0 Jun 10 05:07 ..
```

Load the compiled SSDT:

```bash
sudo mkdir /sys/kernel/config/acpi/table/lsm6dso
sudo sh -c 'cat /home/lubuntu/acpi-lsm6dso/ssdt-lsm6dso.aml > /sys/kernel/config/acpi/table/lsm6dso/aml'
```

Check the kernel log:

```bash
sudo dmesg | grep -i -E "LSM6DSO|IMU0|PRP0001|st_lsm6|iio|acpi"
```

Example output:
```bash
[    0.000000] BIOS-e820: [mem 0x000000007154b000-0x0000000071629fff]  ACPI data
[    0.000000] BIOS-e820: [mem 0x000000007162a000-0x00000000716e9fff]  ACPI NVS
[    0.000000] efi: ACPI=0x716c6000 ACPI 2.0=0x716c6014 TPMFinalLog=0x71695000 SMBIOS=0x71cb7000 SMBIOS 3.0=0x71cb6000 MEMATTR=0x65d76698 ESRT=0x6a8c0998 MOKvar=0x71ccc000 INITRD=0x65d5e598 TPMEventLog=0x71574018
[    0.020379] ACPI: Early table checksum verification disabled
[...]
[    0.575855] ACPI: button: Sleep Button [SLPB]
[    0.575898] ACPI: button: Power Button [PWRB]
[    0.575944] ACPI: button: Power Button [PWRF]
[    0.578032] acpi LNXTHERM:00: registered as thermal_zone0
[    0.578036] ACPI: thermal: Thermal Zone [TZ00] (28 C)
[    0.698246] ACPI: bus type drm_connector registered
# And meaningful log starts here:
[ 8275.948734] i2c i2c-4: new_device: Instantiated device lsm6dso at 0x6a
[ 8275.967771] st_lsm6dsx_i2c 4-006a: supply vdd not found, using dummy regulator
[ 8275.967864] st_lsm6dsx_i2c 4-006a: supply vddio not found, using dummy regulator
[ 8276.474306] st_lsm6dsx_i2c 4-006a: mounting matrix not found: using identity...
[ 8296.108549] i2c i2c-4: delete_device: Deleting device lsm6dso at 0x6a
[ 8700.349931] ACPI: Host-directed Dynamic ACPI Table Load:
[ 8700.349954] ACPI: SSDT 0xFFFF8AF8424DEB00 0000F4 (v02 USER   LSM6DSO  00000001 INTL 20251212)
```

At this point, the kernel should have loaded the new ACPI table and created an ACPI-enumerated I²C device for the IMU.

### Loading the kernel driver

Load the LSM6DSO I²C driver:

```bash
sudo modprobe st_lsm6dsx_i2c
```

Verify that the module is loaded:

```bash
lsmod | grep -E "st_lsm6dsx|industrial"
```

Example output:
```bash
st_lsm6dsx_spi         16384  0
st_lsm6dsx_i2c         16384  0
st_lsm6dsx             73728  2 st_lsm6dsx_i2c,st_lsm6dsx_spi
industrialio_triggered_buffer    12288  1 st_lsm6dsx
kfifo_buf              12288  2 industrialio_triggered_buffer,st_lsm6dsx
industrialio          139264  3 industrialio_triggered_buffer,kfifo_buf,st_lsm6dsx
```

Check ACPI-created I²C devices:

```bash
for d in /sys/bus/i2c/devices/i2c-PRP0001:*; do
    echo "=== $d ==="
    cat "$d/name" 2>/dev/null
    cat "$d/modalias" 2>/dev/null

    if [ -L "$d/driver" ]; then
        echo "BOUND TO:"
        readlink -f "$d/driver"
    else
        echo "NOT BOUND"
    fi
done
```

A successful result should show a device named `lsm6dso` bound to the `st_lsm6dsx_i2c` driver.

Example:

```text
=== /sys/bus/i2c/devices/i2c-PRP0001:00 ===
lsm6dso
of:Nimu0TCst,lsm6dso
BOUND TO:
/sys/bus/i2c/drivers/st_lsm6dsx_i2c
```

After binding, `i2cdetect` should show `UU` at address `0x6a`, meaning the address is now claimed by a kernel driver:

```bash
sudo i2cdetect -y -r 4
```

Expected relevant part:

```text
60: -- -- -- -- -- -- -- -- 68 -- UU -- -- -- -- --
```

### Verifying IIO devices

The `st_lsm6dsx_i2c` driver exposes the LSM6DSO through the Linux IIO subsystem.

Check available IIO devices:

```bash
grep -R . /sys/bus/iio/devices/iio:device*/name
```

Expected result:

```text
/sys/bus/iio/devices/iio:device0/name:lsm6dso_gyro
/sys/bus/iio/devices/iio:device1/name:lsm6dso_accel
```

The exact numbering may vary. Resolve the device paths by name:

```bash
GYRO_DEV=$(dirname "$(grep -l '^lsm6dso_gyro$' /sys/bus/iio/devices/iio:device*/name)")
ACCEL_DEV=$(dirname "$(grep -l '^lsm6dso_accel$' /sys/bus/iio/devices/iio:device*/name)")
```

Verify:

```bash
echo "$GYRO_DEV"
echo "$ACCEL_DEV"
```

Read gyroscope values:

```bash
cat "$GYRO_DEV/in_anglvel_x_raw"
cat "$GYRO_DEV/in_anglvel_y_raw"
cat "$GYRO_DEV/in_anglvel_z_raw"
cat "$GYRO_DEV/in_anglvel_scale"
```

Example returned values:
```bash
40
10
63
0.000152716
```

Read accelerometer values:

```bash
cat "$ACCEL_DEV/in_accel_x_raw"
cat "$ACCEL_DEV/in_accel_y_raw"
cat "$ACCEL_DEV/in_accel_z_raw"
cat "$ACCEL_DEV/in_accel_scale"
```
Example returned values:
```bash
287
-227
16419
0.000598205
```

At this point the IMU is fully visible to Linux as a normal kernel-managed sensor.

### Using the accelerometer for screen rotation

On Linux tablets and convertibles, the usual path is:

```text
accelerometer hardware
    ↓
kernel sensor driver
    ↓
IIO subsystem
    ↓
iio-sensor-proxy
    ↓
desktop environment
    ↓
screen rotation
```

The kernel driver exposes the accelerometer through the Linux IIO subsystem, usually under `/sys/bus/iio/devices/`. A userspace daemon called `iio-sensor-proxy` reads the accelerometer data, converts it into orientation states such as `normal`, `left-up`, `right-up`, or `bottom-up`, and exposes that information over D-Bus. Desktop environments such as GNOME and KDE/Plasma can then use that orientation information to rotate the display automatically.

In this project, the LSM6DSO follows the same general Linux model. After the ACPI SSDT creates the I²C device and the `st_lsm6dsx_i2c` driver binds to it, Linux exposes two IIO devices: one for the gyroscope and one for the accelerometer. The accelerometer device is the one needed for screen rotation.

On a full tablet-oriented desktop stack, `iio-sensor-proxy` may handle the orientation automatically. In this Lubuntu/X11 setup, the same idea can also be implemented manually: read the accelerometer X/Y values from IIO, decide the current orientation, and call `xrandr` to rotate the screen.

Although the chip also contains a gyroscope, screen rotation should use the accelerometer. The accelerometer measures the gravity vector, so it can tell which side of the device is currently pointing down.

First, install display and sensor helper tools:

```bash
sudo apt install -y iio-sensor-proxy x11-xserver-utils
```

Check the connected display name:

```bash
xrandr --query
```

Example output:

```text
HDMI-1 connected
```

Test manual rotation:

```bash
xrandr --output HDMI-1 --rotate left
xrandr --output HDMI-1 --rotate normal
xrandr --output HDMI-1 --rotate right
xrandr --output HDMI-1 --rotate inverted
```

If manual rotation works, the next step is to use the accelerometer values to choose the correct orientation.

A simple direct-IIO rotation script can read the accelerometer raw X and Y values and rotate the screen based on the dominant axis:

```bash
#!/usr/bin/env bash

DISPLAY_OUT="HDMI-1"

ACCEL_DEV=$(grep -l "lsm6dso_accel" /sys/bus/iio/devices/iio:device*/name | sed 's|/name||')

if [ -z "$ACCEL_DEV" ]; then
    echo "Could not find lsm6dso_accel IIO device"
    exit 1
fi

echo "Using accelerometer: $ACCEL_DEV"
echo "Using display: $DISPLAY_OUT"

last=""

while true; do
    x=$(cat "$ACCEL_DEV/in_accel_x_raw")
    y=$(cat "$ACCEL_DEV/in_accel_y_raw")

    ax=${x#-}
    ay=${y#-}

    if [ "$ay" -gt "$ax" ]; then
        if [ "$y" -gt 0 ]; then
            rot="normal"
        else
            rot="inverted"
        fi
    else
        if [ "$x" -gt 0 ]; then
            rot="right"
        else
            rot="left"
        fi
    fi

    if [ "$rot" != "$last" ]; then
        echo "Rotation: $rot   x=$x y=$y"
        xrandr --output "$DISPLAY_OUT" --rotate "$rot"
        last="$rot"
    fi

    sleep 1
done
```

Save it as:

```bash
nano ~/autorotate-iio.sh
```

Make it executable:

```bash
chmod +x ~/autorotate-iio.sh
```

Run it:

```bash
~/autorotate-iio.sh
```

Now rotating the computer should rotate the display.

screen rotation

### Final result

The final data path looks like this:

```text
ST LSM6DSO IMU
    ↓
I²C bus 4, address 0x6a
    ↓
ACPI SSDT overlay
    ↓
PRP0001 ACPI device with compatible = "st,lsm6dso"
    ↓
Linux st_lsm6dsx_i2c driver
    ↓
Linux IIO subsystem
    ↓
lsm6dso_gyro and lsm6dso_accel
    ↓
userspace autorotation script
    ↓
xrandr screen rotation
```

The important result is that the IMU is no longer just manually accessed with `i2cget` and `i2cset`. It is described to the OS through ACPI, bound to a real in-kernel driver, exposed through the standard Linux IIO subsystem, and used by userspace to implement a real feature.

## Summary and conclusions  

The goal of this research was to check how I²C/SMBus devices can be accessed and integrated on an x86 platform.

The first goal was achieved: sensors connected to the prototype board were detected and accessed from Linux using `i2c-tools`. Temperature sensors, a GPIO expander, and an IMU were successfully read or controlled directly from userspace.

The second goal was also achieved: the existing Linux `st_lsm6dsx_i2c` driver was manually bound to the LSM6DSO IMU. After binding, the sensor was exposed through the Linux IIO subsystem as standard accelerometer and gyroscope devices.

The third goal was partially changed. Instead of continuing directly with Windows 11, the same ACPI-based integration concept was tested on Lubuntu. A custom SSDT overlay was created, compiled, and loaded at runtime. This allowed the IMU to be described through ACPI, bound automatically to the Linux kernel driver, and used from userspace for screen rotation.

Overall, the research confirmed that raw I²C communication on x86 is straightforward once the correct bus is found, but proper system integration depends on firmware description, driver binding, and OS-specific infrastructure. Linux provides a convenient path for bring-up and experimentation, while Windows integration requires further work with ACPI tables, INF files, WDK tooling, and driver signing.

## Further work

* Make the ACPI SSDT overlay load automatically during boot.
* Return to the original Windows 11 goal and test ACPI-based device enumeration there.
* Prepare the required Windows INF/driver-binding setup for the selected I²C device.
* Resolve the MAX6650 address conflict and complete fan-controller testing.
* Replace the simple screen-rotation script with a cleaner `iio-sensor-proxy` or daemon-based solution.
* Investigate firmware-level ACPI integration for a production-like x86 platform.

## References  

### Hardware Design 

- **PCBWay PCB Manufacturing Service** – PCBWay – [Link](https://www.pcbway.com/pcb_prototype/)
- **PCBWay PCB Assembly Service** – PCBWay – [Link](https://www.pcbway.com/pcb-assembly.html)
- **PCB Design & Layout – PCB Prototype the Easy Way** – PCBWay, 2024 – [Link](https://www.pcbway.com/pcb_prototype/PCB_Design_and_Layout.html)  
- **PCB Design Guidelines – Engineering Technical** – PCBWay, 2024 – [Link](https://www.pcbway.com/blog/Engineering_Technical/PCB_Design_Guidelines.html)  
- **PCB Layout Best Practices for Improved Performance and Manufacturability** – PCBWay, 2026 – [Link](https://www.pcbway.com/blog/PCB_Design_Layout/PCB_Layout_Best_Practices_for_Improved_Performance_and_Manufacturability_1d7f7e2e.html)  
- **PCB Layout Design Process from Schematic to Manufacturing** – PCBWay, 2025 – [Link](https://www.pcbway.com/blog/PCB_Design_Layout/PCB_Layout_Design_Process_From_Schematic_to_Final_Board_cfaf09e0.html)  
- **PCBWay Brochure – Capabilities & Specifications** – PCBWay, 2026 – [Link](https://www.pcbway.com/blog/News/Explore_the_PCBWay_Brochure_to_learn_about_our_capabilities_d72a5dff.html)  

### Device‑Specific Datasheets & Reference Manuals

- **STTS22H Digital Temperature Sensor Datasheet** – STMicroelectronics – [Link](https://www.st.com/resource/en/datasheet/stts22h.pdf)
- **TCA9536 4-Bit I²C and SMBus I/O Expander Datasheet** – Texas Instruments – [Link](https://www.ti.com/lit/gpn/TCA9536)
- **TMP275 Digital Temperature Sensor Datasheet** – Texas Instruments – [Link](https://www.ti.com/lit/pdf/sbos363)
- **TMP100 / TMP101 Digital Temperature Sensor Datasheet** – Texas Instruments – [Link](https://www.ti.com/lit/gpn/TMP100)
- **LSM6DSO 6-Axis IMU Datasheet** – STMicroelectronics – [Link](https://www.st.com/resource/en/datasheet/lsm6dso.pdf)
- **MPU-6000 / MPU-6050 Register Map and Descriptions** – TDK InvenSense – [Link](https://invensense.tdk.com/wp-content/uploads/2015/02/MPU-6000-Register-Map1.pdf)
- **MPU-6000 / MPU-6050 Product Specification** – TDK InvenSense – [Link](https://www.cdiweb.com/datasheets/invensense/mpu-6050_datasheet_v3%204.pdf)
- **BNO055 Intelligent 9-Axis Absolute Orientation Sensor Datasheet** – Bosch Sensortec – [Link](https://www.bosch-sensortec.com/media/boschsensortec/downloads/datasheets/bst-bno055-ds000.pdf)
- **MAX6650 / MAX6651 Fan-Speed Regulators and Monitors Datasheet** – Analog Devices / Maxim Integrated – [Link](https://www.analog.com/media/en/technical-documentation/data-sheets/MAX6650-MAX6651.pdf)
- **LTC1710 SMBus Dual High-Side Switch Datasheet** – Analog Devices / Linear Technology – [Link](https://www.analog.com/media/en/technical-documentation/data-sheets/1710f.pdf)

### ACPI / UEFI on x86

- **ACPI Specification (v6.5)** – ACPI Foundation, 2023 – [Link](https://uefi.org/specs/ACPI/6.5)
- **UEFI Specification (v2.11)** – UEFI Forum, 2024 – [Link](https://uefi.org/sites/default/files/resources/UEFI_Spec_Final_2.11.pdf)
- **Linux ACPI Documentation** – Linux Kernel Team, 2024 – [Link](https://docs.kernel.org/firmware-guide/acpi/index.html)
- **acpica-tools – ACPI Table Editor on Linux** – [Link](https://docs.kernel.org/driver-api/acpi/linuxized-acpica.html)
- **ACPI System Management Bus Interface Specification** – UEFI Forum – [Link](https://uefi.org/specs/ACPI/6.5/13_System_Mgmt_Bus_Interface_Specification.html)
- **Device Specific Data (_DSD) Implementation Guide** – UEFI Forum – [Link](https://github.com/UEFI/DSD-Guide)
- **ACPICA Project Overview** – Intel – [Link](https://www.intel.com/content/www/us/en/developer/topic-technology/open/acpica/overview.html)
- **ACPICA Downloads and Tools** – Intel – [Link](https://www.intel.com/content/www/us/en/developer/topic-technology/open/acpica/download.html)
- **iASL Compiler User Reference** – Intel – [Link](https://cdrdv2-public.intel.com/772727/aslcompiler-11.pdf)

### Intel / x86 platform documentation

- **Processor and Intel Core i3 N-Series Datasheet, Volume 1** – Intel – [Link](https://edc.intel.com/content/www/us/en/design/products/platforms/processor-and-core-i3-n-series-datasheet-volume-1-of-2/001/introduction/)
- **Intel Pentium and Celeron N-Series Datasheet, Volume 1** – Intel – [Link](https://cdrdv2-public.intel.com/332092/pentium-celeron-n-series-datasheet-vol-1.pdf)
- **DesignWare I²C Controller IP Overview** – Synopsys – [Link](https://www.synopsys.com/designware-ip/soc-infrastructure-ip/amba/i2c.html)

### LattePanda Mu platform

- **LattePanda Mu Documentation** – LattePanda – [Link](https://docs.lattepanda.com/content/mu_edition/introduction/)
- **LattePanda Mu GPIO / I²C Documentation** – LattePanda – [Link](https://docs.lattepanda.com/content/mu_edition/gpio_ctl/)
- **How to Use the I²C Port on LattePanda Mu in Ubuntu OS** – LattePanda Forum – [Link](https://www.lattepanda.com/forum/topic/336132)
- **DFR1142 Lite Carrier Board Design Guide** – LattePanda, 2024 – [Link](http://docs.lattepanda.com/content/mu_edition/lite_carrier/)  
- **DFR1141 Full Evaluation Carrier (Schematics & Gerbers)** – LattePanda, 2024 – [Link](http://docs.lattepanda.com/content/mu_edition/full_eval/)  
- **Lite Carrier Board Product Page (DFRobot)** – DFRobot, 2024 – [Link](https://www.dfrobot.com/product-2822.html)  

### Linux I²C / SMBus subsystem

- **Linux I²C and SMBus Subsystem Documentation** – Linux Kernel Documentation – [Link](https://docs.kernel.org/i2c/index.html)
- **Implementing I²C Device Drivers in Userspace** – Linux Kernel Documentation – [Link](https://docs.kernel.org/i2c/dev-interface.html)
- **Linux I²C Sysfs Documentation** – Linux Kernel Documentation – [Link](https://docs.kernel.org/i2c/i2c-sysfs.html)
- **How to Instantiate I²C Devices** – Linux Kernel Documentation – [Link](https://docs.kernel.org/i2c/instantiating-devices.html)
- **Writing I²C Client Drivers** – Linux Kernel Documentation – [Link](https://docs.kernel.org/i2c/writing-clients.html)
- **I²C / SMBus Functionality** – Linux Kernel Documentation – [Link](https://docs.kernel.org/i2c/functionality.html)
- **i2c-tools Repository** – Linux Kernel / lm-sensors Project – [Link](https://kernel.googlesource.com/pub/scm/utils/i2c-tools/i2c-tools/)
- **i2c-tools GitHub Mirror** – lm-sensors Project – [Link](https://github.com/lm-sensors/i2c-tools)
- **smbus2 Python Package** – PyPI – [Link](https://pypi.org/project/smbus2/)

### Linux ACPI device enumeration and SSDT overlays

- **ACPI Based Device Enumeration** – Linux Kernel Documentation – [Link](https://docs.kernel.org/firmware-guide/acpi/enumeration.html)
- **SSDT Overlays** – Linux Kernel Documentation – [Link](https://docs.kernel.org/admin-guide/acpi/ssdt-overlays.html)
- **PRP0001 Device ID and _DSD Device Properties** – Linux Kernel Documentation – [Link](https://docs.kernel.org/firmware-guide/acpi/enumeration.html#device-tree-namespace-link-device-id)
- **ACPI Device Properties** – Linux Kernel Documentation – [Link](https://docs.kernel.org/firmware-guide/acpi/DSD-properties-rules.html)

### Linux IIO / sensors / screen rotation

- **Industrial I/O Subsystem Documentation** – Linux Kernel Documentation – [Link](https://docs.kernel.org/iio/index.html)
- **Industrial I/O Device Buffers** – Linux Kernel Documentation – [Link](https://docs.kernel.org/iio/iio_devbuf.html)
- **ST LSM6DSx IIO Driver Source** – Linux Kernel – [Link](https://github.com/torvalds/linux/blob/master/drivers/iio/imu/st_lsm6dsx/st_lsm6dsx_core.c)
- **ST LSM6DSx I²C Driver Source** – Linux Kernel – [Link](https://github.com/torvalds/linux/blob/master/drivers/iio/imu/st_lsm6dsx/st_lsm6dsx_i2c.c)
- **ST LSM6DSx Device Tree Binding** – Linux Kernel Documentation – [Link](https://www.kernel.org/doc/Documentation/devicetree/bindings/iio/imu/st_lsm6dsx.txt)
- **CONFIG_IIO_ST_LSM6DSX Kernel Option** – kernelconfig.io – [Link](https://www.kernelconfig.io/CONFIG_IIO_ST_LSM6DSX)
- **iio-sensor-proxy** – hadess / freedesktop.org – [Link](https://github.com/hadess/iio-sensor-proxy)
- **xrandr Manual Page** – Ubuntu Manpages – [Link](https://manpages.ubuntu.com/manpages/focal/man1/xrandr.1.html)

### Windows 11 / SPB / ACPI sensor support

- **Simple Peripheral Bus Driver Design Guide** – Microsoft Learn – [Link](https://learn.microsoft.com/en-us/windows-hardware/drivers/spb/)
- **Simple Peripheral Bus in Platform Bring-Up** – Microsoft Learn – [Link](https://learn.microsoft.com/en-us/windows-hardware/drivers/bringup/simple-peripheral-bus--spb-)
- **How to Get the Connection Settings for a Device** – Microsoft Learn – [Link](https://learn.microsoft.com/en-us/windows-hardware/drivers/spb/how-to-get-the-connection-settings-for-a-device)
- **Windows ACPI Design Guide for SoC Platforms** – Microsoft Learn – [Link](https://learn.microsoft.com/en-us/windows-hardware/drivers/bringup/windows-acpi-design-guide-for-soc-platforms)
- **Skeleton I²C Sample Driver** – Microsoft Learn – [Link](https://learn.microsoft.com/en-us/samples/microsoft/windows-driver-samples/skeleton-i2c-sample-driver/)
- **Skeleton I²C ASL Example** – Microsoft Windows Driver Samples – [Link](https://github.com/microsoft/Windows-driver-samples/blob/main/spb/SkeletonI2C/skeletoni2c.asl)
- **Sensor Device Driver Design Guide** – Microsoft Learn – [Link](https://learn.microsoft.com/en-us/windows-hardware/drivers/sensors/)
- **Install the Sensor Driver** – Microsoft Learn – [Link](https://learn.microsoft.com/en-us/windows-hardware/drivers/sensors/install-the-sensor-driver)
- **HID over I²C Guide** – Microsoft Learn – [Link](https://learn.microsoft.com/en-us/windows-hardware/drivers/hid/hid-over-i2c-guide)
