lukasznowarkiewicz/I2C-SMBus-on-x86-architecture-research/design_files/02 complete design with layout/Project Outputs for SMBUS-I2C-sensors-proto/BOM/SMBUS-I2C-sensors-proto.csv

Comment | Description | Designator | Footprint | LibRef | Quantity
GRM155R71H104KE14D | Chip Multilayer Ceramic Capacitors for General Purpose, 0402, 0.10uF, X7R, 15%, 10%, 50V | C1, C2, C3, C4, C5, C6, C7, C12, C14, C15, C18, C19 | FP-GRM155-0_05-IPC_B | CMP-2008-04639-2 | 12
0603YC105JAT2A |  | C8, C9, C16 | CAPC1608X90X35NL15T15 | CMP-1035-02736-2 | 3
GCM188R71E105KA64D |  | C10, C11 | FP-GCM188-0_1-MFG | CMP-2006-02363-4 | 2
VJ0603Y222KXCAC |  | C13 | CAPC1608X92X38NL15T08 | CMP-2006-01127-1 | 1
GRM188R60J106ME47D | Chip Multilayer Ceramic Capacitors for General Purpose, 0603, 10uF, X5R, 15%, 20%, 6.3V | C17 | FP-GRM188-0_1-e0_2_0_55-IPC_A | CMP-2006-02792-2 | 1
150080VS75000 | WL-SMCW SMT Mono-Color Chip LED Waterclear | D1, D2, D3, D4 | WL-SMCW_0805_150080xx75000 | CMP-1426-00009-6 | 4
742792011 |  | FB1 | WE-CBF_0805_L2W1.2H0.9_HC | CMP-0220-00043-2 | 1
S3B-ZR-SM4A-TF(LF)(SN) | CONN HEADER SMD R/A 3POS 1.5MM | J1 | FP-S3B-ZR-SM4A-TF_LF_SN-MFG | CMP-17439-000744-1 | 1
61300511121 | THT Vertical Pin Header WR-PHD, Pitch 2.54 mm, Single Row, 5 pins | P1, P2 | 61300511121 | CMP-1502-01068-4 | 2
CSD16301Q2 | MOSFET N-CH 25V 6-SON | Q1 | FP-CSD16301Q2-MFG | CMP-04962-000001-1 | 1
RC0402JR-100RL |  | R1, R5, R6, R7, R10, R11, R14, R15, R16, R17, R21, R23, R24, R25, R29, R30 | RESC1005X40X25NL05T10 | CMP-2002-06970-1 | 16
CRCW04024K70FKED | RES Thick Film, 4.7kO, 1%, 0.063W, 100ppm/°C, 0402 | R2, R3, R4, R8, R9, R22, R26, R27, R28 | FP-CRCW0402-e3-IPC_B | CMP-2002-00051-3 | 9
ERA3AEB4020V |  | R12, R13, R18, R19 | RESC1608X55X30ML20T20 | CMP-2000-00056-1 | 4
RC0402FR-0710KL |  | R20 | RESC1005X40X25LL05T10 | CMP-2002-07353-1 | 1
430481025816 | Switch Tactile Spst-no 0.05A 12V | SW1, SW2 | 430481025816 | CMP-1452-00025-9 | 2
TCA9536DGKR | Remote 4-Bit IÂ²C and SMBus I/O expander with configuration register and interrupt | U1 | SOP65P490X110-8N | TCA9536DGKR | 1
TMP275AIDGKR | SENSOR DIGITAL -40C-125C 8VSSOP | U2 | FP-DGK0008A-IPC_C | CMP-04948-000056-1 | 1
TMP101NA/3K | SENSOR DIGITAL -55C-125C SOT23-6 | U3 | FP-DBV0006A-IPC_A | CMP-04948-000039-1 | 1
STTS22HTR | LOW-VOLTAGE, ULTRA-LOW-POWER, 0. | U4 | FP-UDFN-6L-DM00423052-MFG | CMP-12184-000002-1 | 1
LTC1710IS8#TRPBF | Control Up to 6 Peripherals on Same Bus, 2.7 to 5.5 V Vin, 8-pin SOIC (S8-8), -40 to 85 degC, Pb-Free, Tape and Reel | U5 | LT-S8-8_M | CMP-0479-00585-1 | 1
AMS1117-3.3 | LDO Voltage Regulators 1A, 3.3V | U6 | FP-AMS1117-IPC_C | CMP-209535-000001-1 | 1
MPU-6050 | 3-Axis Gyroscope, Accelerometer and a Digital Motion Processor(TM) (DMP), 2.375 to 3.46 V, -40 to 85 degC, 24-Pin QFN, RoHS, Tape and Reel | U7 | IS-QFN-24_V | CMP-1753-00002-2 | 1
MAX6650EUB+ | Fan-Speed Regulator and Monitor with I2C / SMBus Interface, -40 to 85 degC, 10-Pin SOP (U10+2), Pb-Free | U8 | MAXM-U10+2_N | CMP-0253-00590-1 | 1
BNO055 | IMU ACCEL/GYRO/MAG I2C 28LGA | U9 | FP-BNO055-MFG | CMP-2000-05075-4 | 1
LSM6DSOTR | CONSUMER MEMS | U10 | FP-LGA-14L-DM00249496-MFG | CMP-12177-000012-1 | 1
