lukasznowarkiewicz/I2C-SMBus-on-x86-architecture-research/design_files/02 complete design with layout/Project Outputs for SMBUS-I2C-sensors-proto/ExportSTEP/PCB1.step

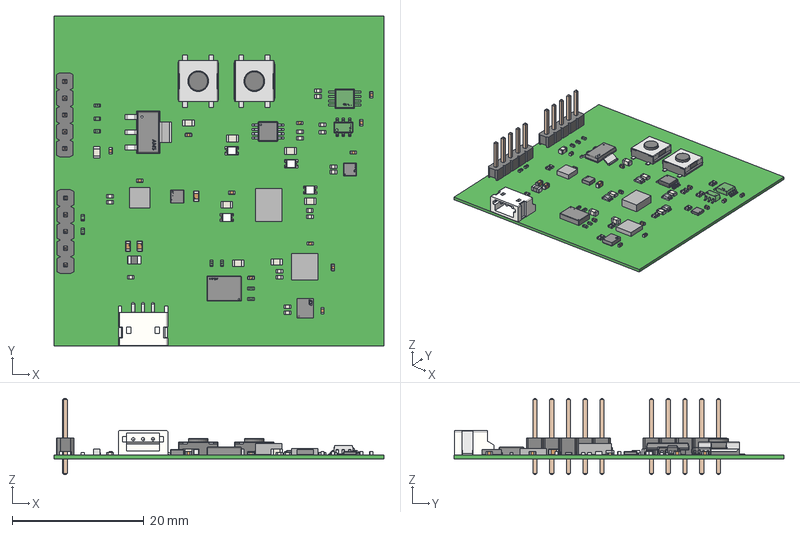
[picture p25: CAD file, 2026-06-14]
design_files/02 complete design with layout/Project Outputs for SMBUS-I2C-sensors-proto/ExportSTEP/PCB1.step
50.0 x 50.0 x 11.5 mm
base x 7
logo x 2
terminals x 2
BNO055--3DModel-STEP-56544
BOSCH logo
Extruded x 78
Notch 2
STM Logo
IC_BODY
IC_LEG x 3
circle x 2
Texas Instruments x 2
IC_LEG_MIR2 x 3
BODY_MUA08A
LEAD_MUA08A x 8
top cover x 2
top x 9
Vishay x 9
BODY-SON
FRAME-DQK0006C
Texas Logo Yury
Texas Logo Yury - Copy (2)
6130xx11121_PIN x 10
S3B-ZR-SM4A-TF
JST Logo adjustable
Lötende x 2
housing x 4
cover x 4
base_2 x 4
marking x 4
side x 24
Murata x 12
Murata Logo 3 x 2
