lukasznowarkiewicz/I2C-SMBus-on-x86-architecture-research/design_files/02 complete design with layout/Project Outputs for SMBUS-I2C-sensors-proto/AssemblyDrawing.pdf

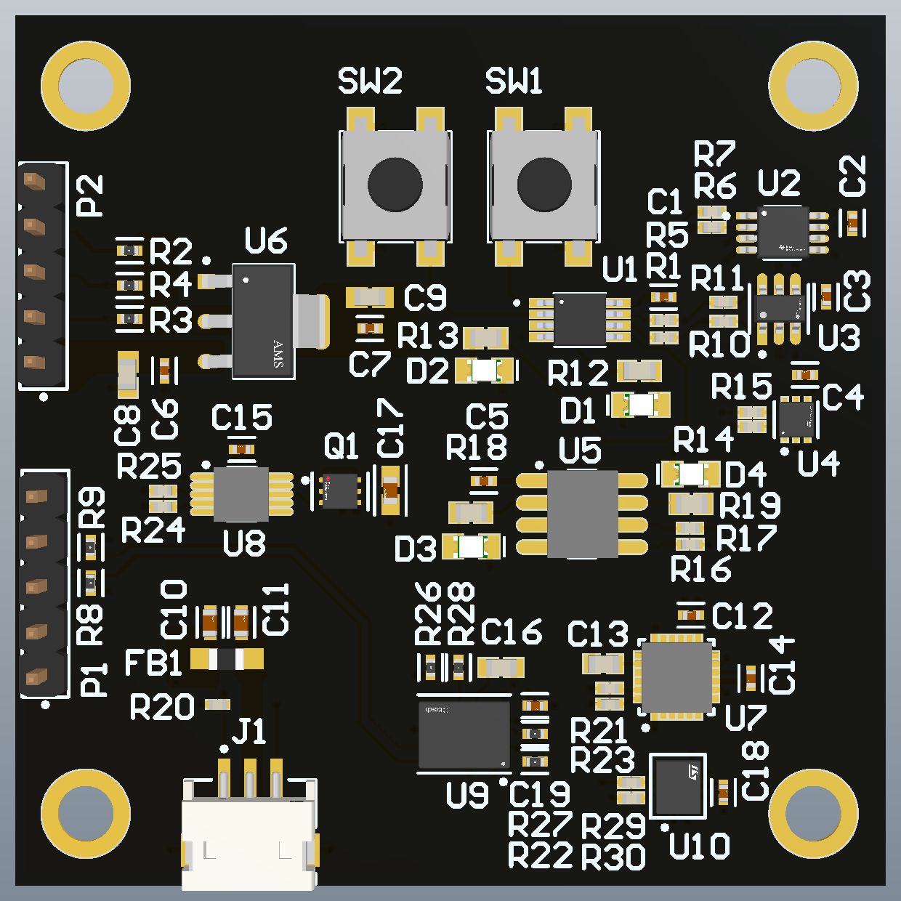
[picture p26: page 1]

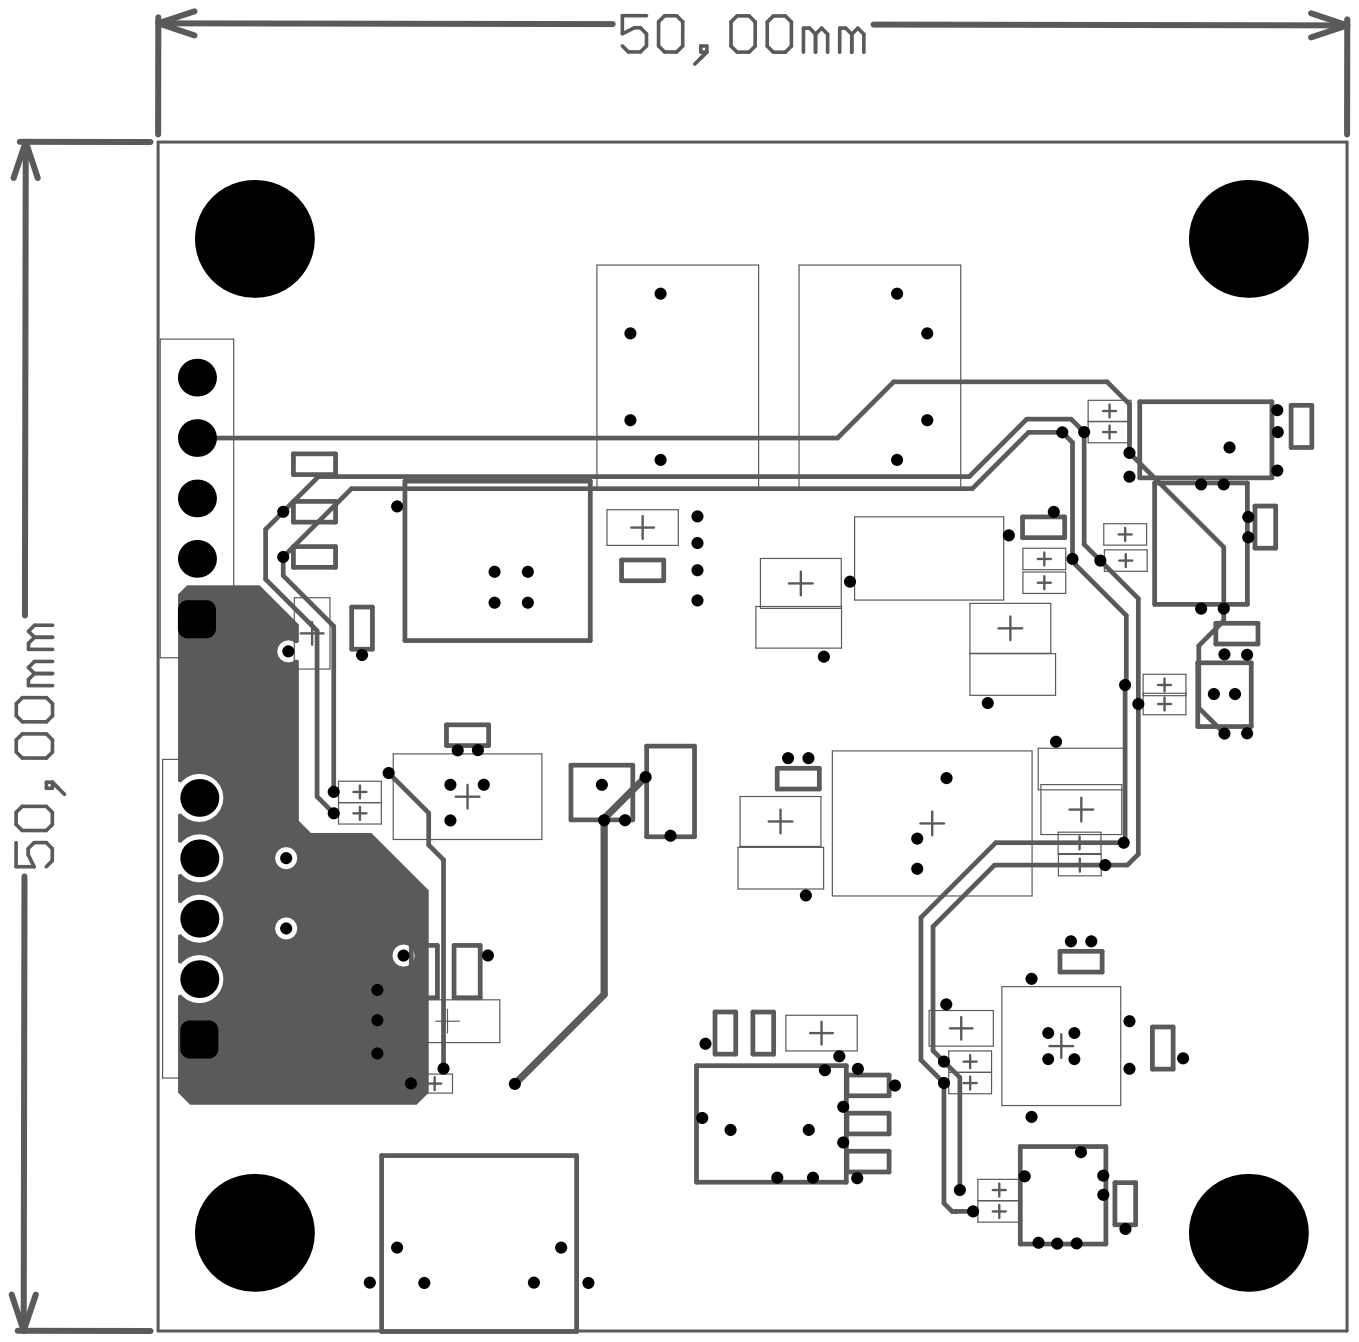
[picture p27: page 2]

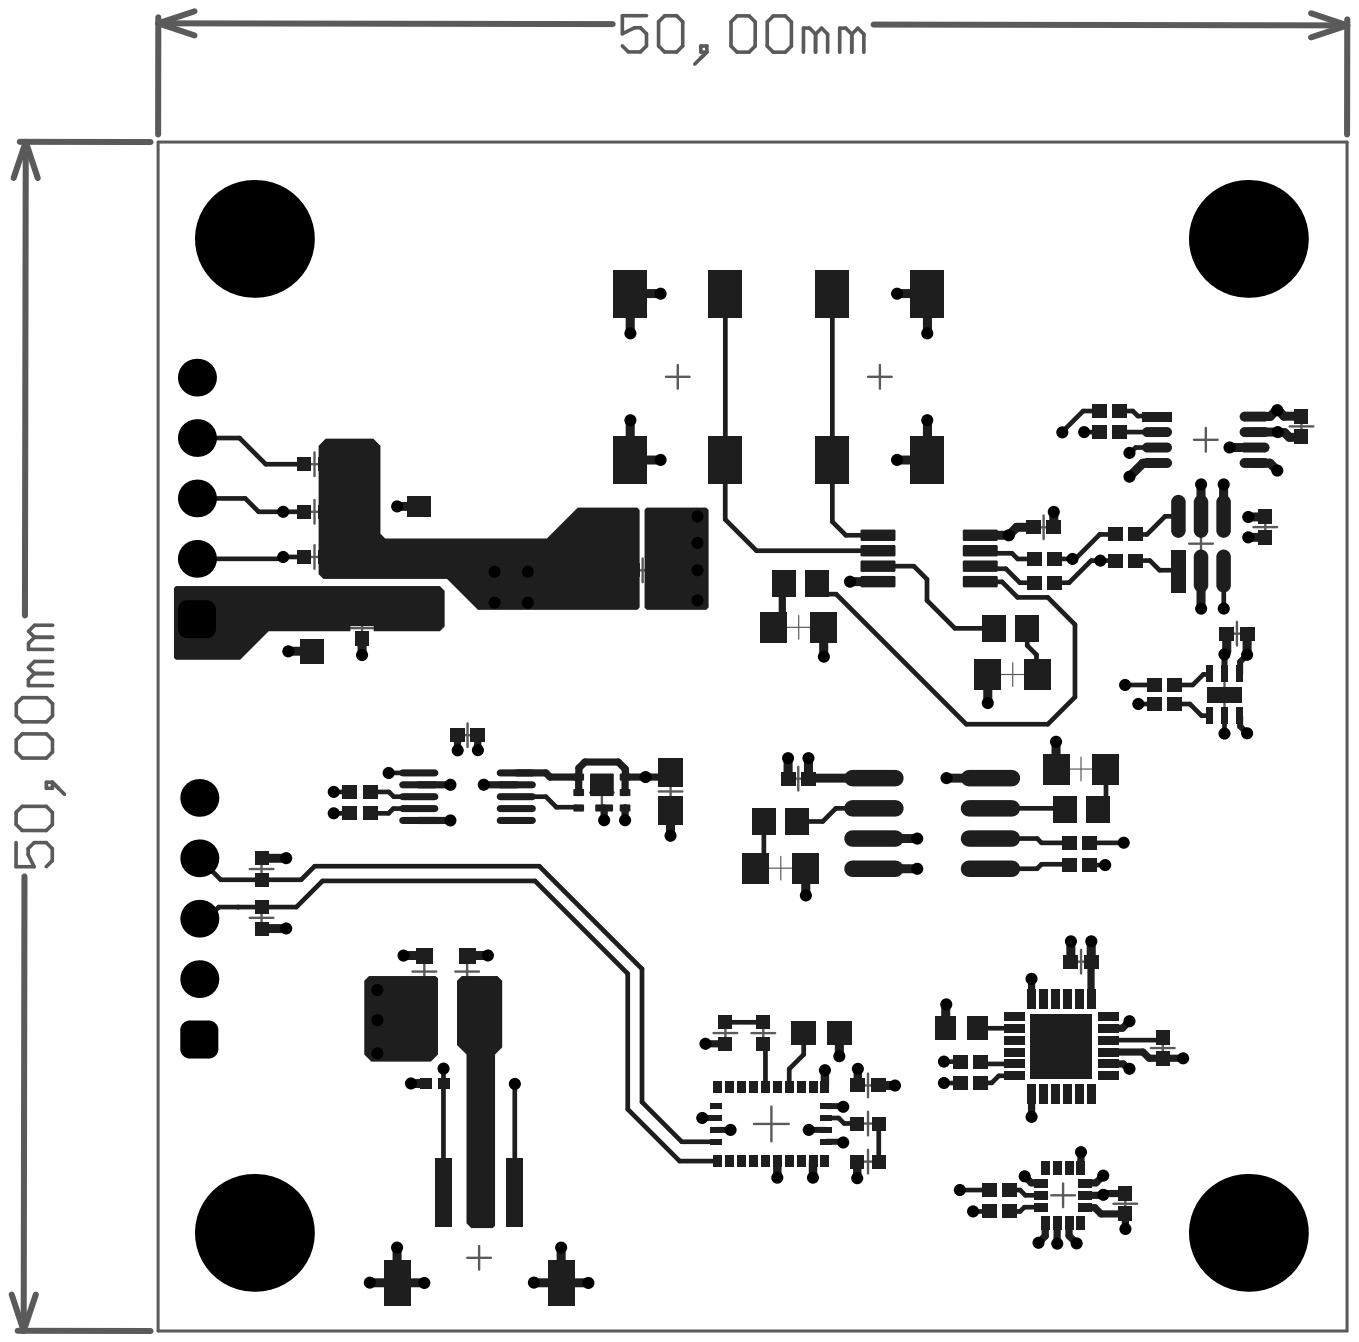
[picture p28: page 3]
