lukasznowarkiewicz/I2C-SMBus-on-x86-architecture-research/design_files/02 complete design with layout/Project Outputs for SMBUS-I2C-sensors-proto/Fabrication.pdf

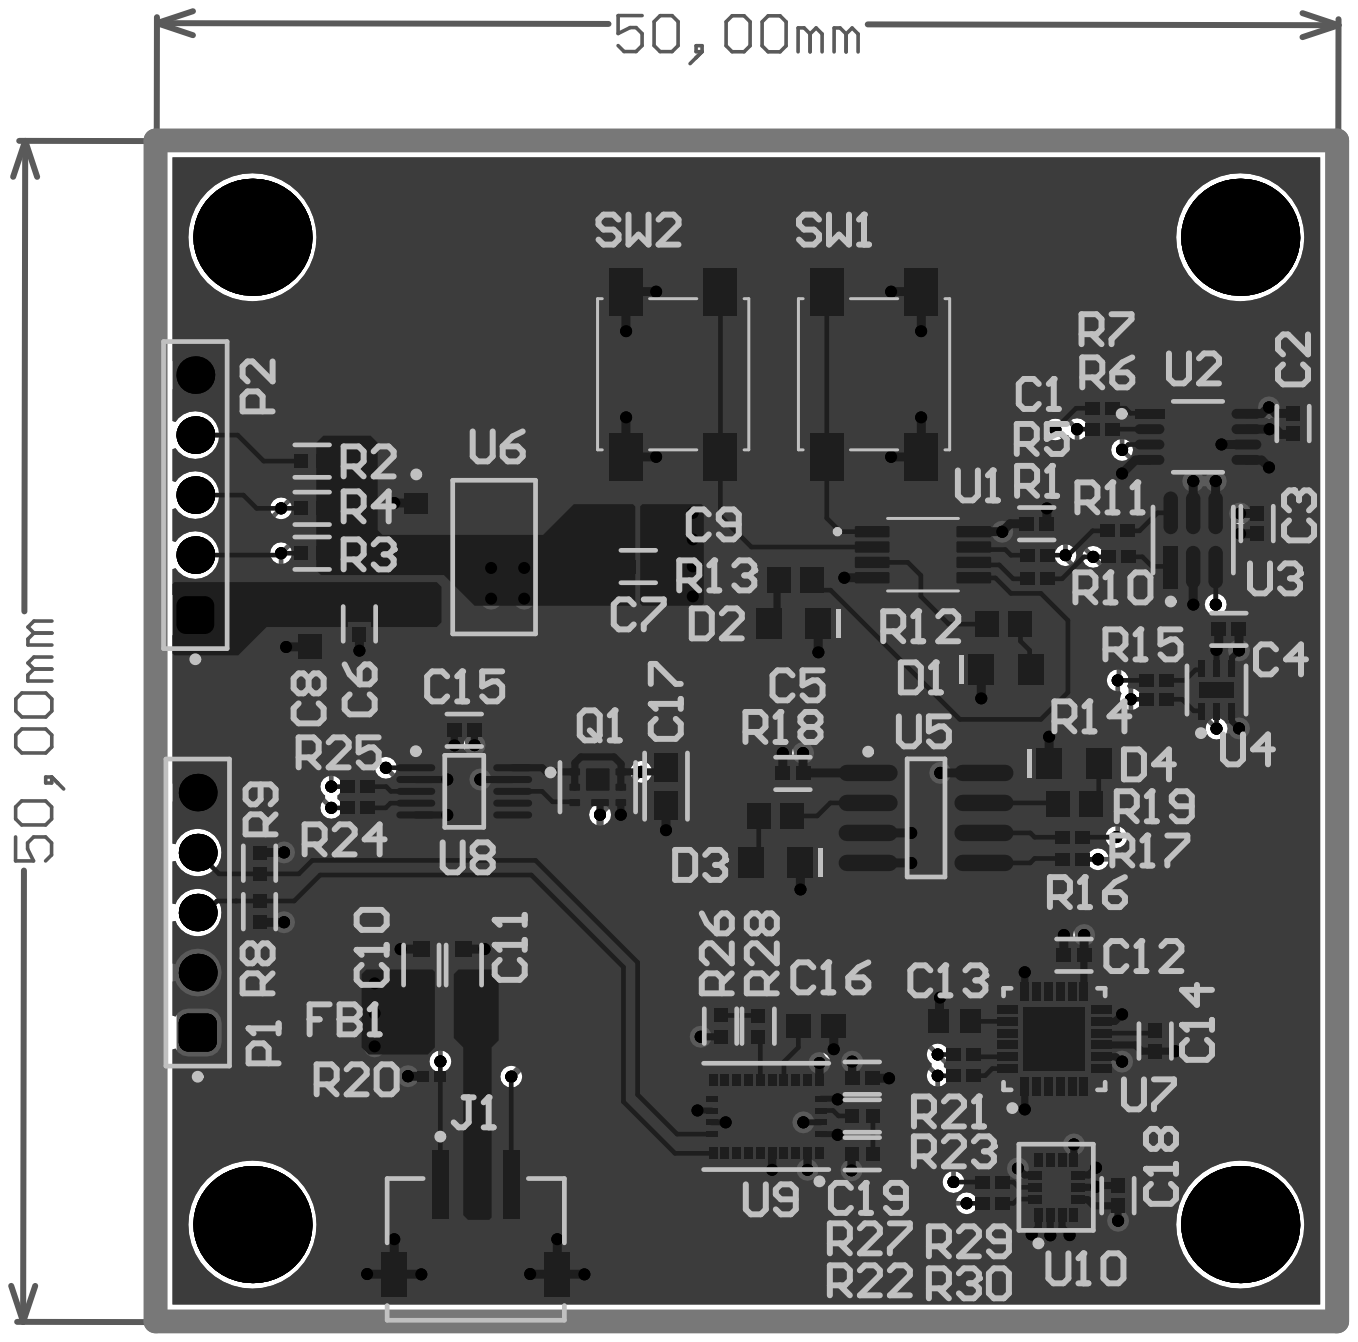
[picture p29: page 1]
