lukasznowarkiewicz/I2C-SMBus-on-x86-architecture-research/(list of files, drawings)

Other design files:
design_files/01 only schematic/PCB1.PcbDoc
design_files/01 only schematic/SMBUS-I2C-sensors-proto.PrjPcb
design_files/01 only schematic/SMBUS_devices.SchDoc
design_files/02 complete design with layout/PCB1.PcbDoc
design_files/02 complete design with layout/PCB1.PcbLib
design_files/02 complete design with layout/Project Outputs for SMBUS-I2C-sensors-proto/ASCII/PCB1.PcbDoc
design_files/02 complete design with layout/SMBUS-I2C-sensors-proto.PrjPcb
design_files/02 complete design with layout/SMBUS_devices.SchDoc
